QUT-Motorsport/QUTMS_MCISO/hardware/MCISO_board_image.PNG

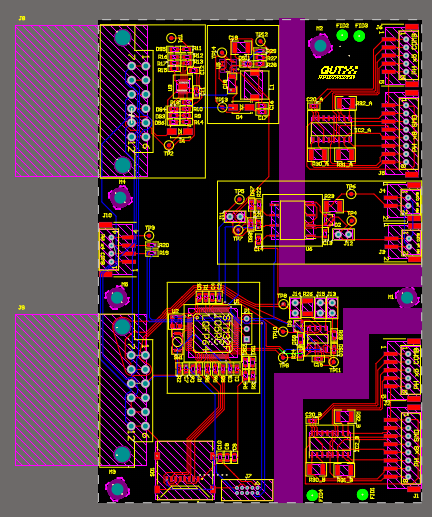
hardware/MCISO_board_image.PNG
