QUT-Motorsport/QUTMS_MCISO/hardware/3D_PCB.PNG

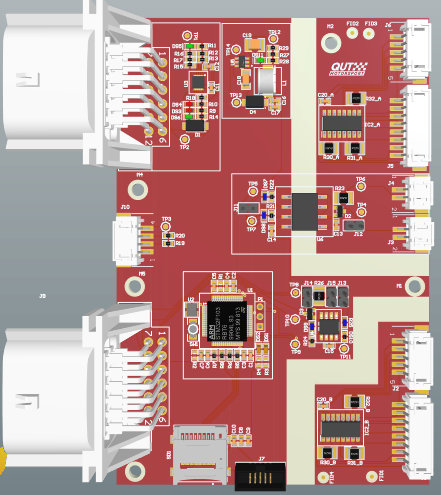
hardware/3D_PCB.PNG
