QUT-Motorsport/QUTMS_MCISO/hardware/JohnAssemblyFiles/QUTMS_MCISO-V01 BOM Expanded.xlsx

Sheet: Pivot
Fit | (Multiple Items)
Row Labels | Count of Designator
1N4448WQ-7-F | 1
47219-2001 | 1
74404064221 | 1
AM26LS32ACDR | 2
B260A-13-F | 1
B3U-1000P | 1
Cap-100nF-0603 | 15
Cap-1uF-0603 | 1
Cap-22uF-1206 | 2
Cap-470nF-0603 | 1
Cap-47uF-1210 | 2
Cap-4u7-0603 | 4
DSC1101CI5-020.0000T | 1
G5V-2-DC12 | 1
Header 3 | 1
IDC 10P 2x5 1.27mm | 1
ISO1050DWR | 1
JST PH 2x RIGHT COMB | 1
JST PH 4x RIGHT COMB | 5
JST PH 5x RIGHT COMB | 2
JST PH 8x Right comb | 2
Jumper 2Way Pins | 2
LED Blue 0603 | 4
LED Green 0603 | 3
LED Orange | 2
LED Red 0603 | 2
LMR14010ADDCR | 1
MAX17612A | 1
NUP2105L | 2
Res-10k-0603 | 2
Res-120R-1210 | 7
Res-150k-0603 | 1
Res-15k-0603 | 1
Res-19k6-0603 | 1
Res-1k-0603 | 2
Res-22R-0603 | 2
Res-240k-0603 | 1
Res-2M2-0603 | 2
Res-330R-0603 | 6
Res-390k-0603 | 1
Res-4k7-0603 | 5
Res-64k9-0603 | 1
SN65HVD232D | 1
STM32F207VGT7 | 1
Grand Total | 98

Sheet: QUTMS_MCISO-V01 BOM Expanded
Comment | Description | Designator | Footprint | LibRef | Quantity | Fit | Unique Part Number | Side
STM32F207VGT7 | ARM Cortex-M3 32-bit MCU, 1024 KB Flash, 128 KB Internal RAM, 82 I/Os, 100-pin LQFP, -40 to 105 degC, Tray | U1 | STM-LQFP100_N | STM32F207VGT7-Custom | 1 | Y | STM32F207VGT7 | T
SN65HVD232D | 3.3 V CAN Transceiver, 17 mA, -40 to 85 degC, 8-pin SOIC (D), Green (RoHS & no Sb/Br) | U4 | D0008A_L | CMP-0315-00073-2 | 1 | Y | SN65HVD232D | T
NUP2105L | NUP2105L | D2 | NUP2105L | NUP2105L | 1 | Y | NUP2105L | T
NUP2105L | NUP2105L | D3 | NUP2105L | NUP2105L | 1 | Y | NUP2105L | T
MAX17612A | 4.5V to 60V, 250mA Current-Limiter with OV, UV, and Reverse Protection | U3 | MAX17612A | MAX17612A | 1 | Y | MAX17612A | T
LMR14010ADDCR | IC REG BUCK ADJ 1A TSOT23-6 | U5 | FP-DDC0006A-MFG | CMP-04918-000056-1 | 1 | Y | LMR14010ADDCR | T
LED Red 0603 | LED Red 0603 | DS3 | LED RED 0603 | LED Red 0603 | 1 | Y | LED Red 0603 | T
LED Red 0603 | LED Red 0603 | DS4 | LED RED 0603 | LED Red 0603 | 1 | Y | LED Red 0603 | T
LED Orange |  | DS1 | LED ORANGE 0603 | LED ORANGE 0603 | 1 | Y | LED Orange | T
LED Orange |  | DS2 | LED ORANGE 0603 | LED ORANGE 0603 | 1 | Y | LED Orange | T
LED Green 0603 | LED Green 0603 | DS5 | LED GREEN 0603 | LED Green 0603 | 1 | Y | LED Green 0603 | T
LED Green 0603 | LED Green 0603 | DS6 | LED GREEN 0603 | LED Green 0603 | 1 | Y | LED Green 0603 | T
LED Green 0603 | LED Green 0603 | DS11 | LED GREEN 0603 | LED Green 0603 | 1 | Y | LED Green 0603 | T
LED Blue 0603 |  | DS7 | LED BLUE 0603 | LED BLUE 0603 | 1 | Y | LED Blue 0603 | T
LED Blue 0603 |  | DS8 | LED BLUE 0603 | LED BLUE 0603 | 1 | Y | LED Blue 0603 | T
LED Blue 0603 |  | DS9 | LED BLUE 0603 | LED BLUE 0603 | 1 | Y | LED Blue 0603 | T
LED Blue 0603 |  | DS10 | LED BLUE 0603 | LED BLUE 0603 | 1 | Y | LED Blue 0603 | T
Jumper 2Way Solderable | Jumper 2Way Side Solderable | J11 | Jumper_2Way_Solderable | Jumper 2Way Side Solderable | 1 | N | Jumper 2Way Solderable | T
Jumper 2Way Solderable | Jumper 2Way Side Solderable | J13 | Jumper_2Way_Solderable | Jumper 2Way Side Solderable | 1 | N | Jumper 2Way Solderable | T
Jumper 2Way Solderable | Jumper 2Way Side Solderable | J14 | Jumper_2Way_Solderable | Jumper 2Way Side Solderable | 1 | N | Jumper 2Way Solderable | T
Jumper 2Way Solderable | Jumper 2Way Side Solderable | J16 | Jumper_2Way_Solderable | Jumper 2Way Side Solderable | 1 | N | Jumper 2Way Solderable | T
Jumper 2Way Pins | Jumper 2Way Side Pins | J8 | Jumper_2Way_Pin | Jumper 2Way Side Pins | 1 | THRU | Jumper 2Way Pins | T
Jumper 2Way Pins | Jumper 2Way Side Pins | J9 | Jumper_2Way_Pin | Jumper 2Way Side Pins | 1 | THRU | Jumper 2Way Pins | T
JST PH 8x Right comb |  | J1 | JST PH 8x RIGHT SMD | JST PH 8x Right comb | 1 | Y | JST PH 8x Right comb | T
JST PH 8x Right comb |  | J5 | JST PH 8x RIGHT SMD | JST PH 8x Right comb | 1 | Y | JST PH 8x Right comb | T
JST PH 5x RIGHT COMB |  | J2 | JST PH 5x RIGHT COMB | JST PH 5x RIGHT COMB | 1 | Y | JST PH 5x RIGHT COMB | T
JST PH 5x RIGHT COMB |  | J6 | JST PH 5x RIGHT COMB | JST PH 5x RIGHT COMB | 1 | Y | JST PH 5x RIGHT COMB | T
JST PH 4x RIGHT COMB |  | J3 | JST PH 4x RIGHT COMB | JST PH 4x RIGHT COMB | 1 | Y | JST PH 4x RIGHT COMB | T
JST PH 4x RIGHT COMB |  | J4 | JST PH 4x RIGHT COMB | JST PH 4x RIGHT COMB_1 | 1 | Y | JST PH 4x RIGHT COMB | T
JST PH 4x RIGHT COMB |  | J10 | JST PH 4x RIGHT COMB | JST PH 4x RIGHT COMB | 1 | Y | JST PH 4x RIGHT COMB | T
JST PH 4x RIGHT COMB |  | J15 | JST PH 4x RIGHT COMB | JST PH 4x RIGHT COMB | 1 | Y | JST PH 4x RIGHT COMB | T
JST PH 4x RIGHT COMB | CAN Ethernet Bridge Port | J12 | JST PH 4x RIGHT COMB | JST PH 4x RIGHT COMB | 1 | Y | JST PH 4x RIGHT COMB | T
JST PH 2x RIGHT COMB |  | J17 | JST PH 2x RIGHT COMB | JST PH 2x RIGHT COMB | 1 | Y | JST PH 2x RIGHT COMB | T
ISO1050DWR | Isolated CAN Transceiver, -55 to 105 degC, 16-pin SOIC (DW), Green (RoHS & no Sb/Br) | U7 | DW00016B_V | ISO1050DWR | 1 | Y | ISO1050DWR | T
IDC 10P 2x5 1.27mm | IDC 10P 2x5 1.27mm | J7 | IDC 1.27MM 10P | IDC 10P 2x5 1.27mm | 1 | THRU | IDC 10P 2x5 1.27mm | T
Hole M3 Tight Unplated | M3.2 Hole, No Plating | M1 | M3.2 UNPLATED | Hole M3 Tight Unplated | 1 | N | Hole M3 Tight Unplated | T
Hole M3 Tight Unplated | M3.2 Hole, No Plating | M2 | M3.2 UNPLATED | Hole M3 Tight Unplated | 1 | N | Hole M3 Tight Unplated | T
Hole M3 Tight Unplated | M3.2 Hole, No Plating | M3 | M3.2 UNPLATED | Hole M3 Tight Unplated | 1 | N | Hole M3 Tight Unplated | T
Hole M3 Tight Unplated | M3.2 Hole, No Plating | M4 | M3.2 UNPLATED | Hole M3 Tight Unplated | 1 | N | Hole M3 Tight Unplated | T
Header 3 | Header, 3-Pin | P1 | HDR1X3 | Header 3 | 1 | THRU | Header 3 | T
G5V-2-DC12 | General Purpose Relay DPDT (2 Form C) Through Hole, 12V, 2A | K1 | G5V-2 | G5V-2-DC12 | 1 | THRU | G5V-2-DC12 | T
DSC1101CI5-020.0000T | No Description Available | U2 | VDFN6_3P2X2P5_MCH | DSC1101CI5-020.0000T | 1 | Y | DSC1101CI5-020.0000T | T
B260A-13-F | Diode, Schottky Barrier Rectifier, 60 V, 2 A, B260A-13-F | D4 | SMA | B260A-13-F | 1 | Y | B260A-13-F | T
B3U-1000P | Omron B3U-1000P Ultra Miniture Switch | SW1 | BTN B3U-1000P | BTN B3U-1000P | 1 | Y | B3U-1000P | T
AM26LS32ACDR | Integrated Circuit | IC2_A | 16PinHallFootprint | AM26LS32ACDR | 1 | Y | AM26LS32ACDR | T
AM26LS32ACDR | Integrated Circuit | IC2_B | 16PinHallFootprint | AM26LS32ACDR | 1 | Y | AM26LS32ACDR | T
74404064221 | FIXED IND 220UH 660MA 850 MOHM | L1 | Inductor_6x6mm | 74404064221 | 1 | Y | 74404064221 | T
47219-2001 | MicroSD Card Connector, Hinge Type, -40 to 85 degC, 8-Pin SMD, RoHS, Tape and Reel | SD1 | MOLX-47219-2001-8_V | CMP-2000-05245-1 | 1 | Y | 47219-2001 | T
470nF 50V 5% | Capacitor, Ceramic, SMD, 470nF, 50V, 5%, X7R, 0603 | C12 | Cap_Ceramic_0603 | 470nF 50V 5% X7R 0603 | 1 | Y | Cap-470nF-0603 | T
390k 5% | Resistor, SMD, 390k, 0.1W, 5%, 0603 | R16 | Res_ThinFilm_0603 | 390k 5% 0603 | 1 | Y | Res-390k-0603 | T
330R | Resistor, SMD, 330R, 0.1W, 5%, 0603 | R3 | Res_ThinFilm_0603 | 330R 5% 0603 | 1 | Y | Res-330R-0603 | T
330R | Resistor, SMD, 330R, 0.1W, 5%, 0603 | R4 | Res_ThinFilm_0603 | 330R 5% 0603 | 1 | Y | Res-330R-0603 | T
330R | Resistor, SMD, 330R, 0.1W, 5%, 0603 | R21 | Res_ThinFilm_0603 | 330R 5% 0603 | 1 | Y | Res-330R-0603 | T
330R | Resistor, SMD, 330R, 0.1W, 5%, 0603 | R22 | Res_ThinFilm_0603 | 330R 5% 0603 | 1 | Y | Res-330R-0603 | T
330R | Resistor, SMD, 330R, 0.1W, 5%, 0603 | R24 | Res_ThinFilm_0603 | 330R 5% 0603 | 1 | Y | Res-330R-0603 | T
330R | Resistor, SMD, 330R, 0.1W, 5%, 0603 | R25 | Res_ThinFilm_0603 | 330R 5% 0603 | 1 | Y | Res-330R-0603 | T
240k 5% | Resistor, SMD, 240k, 0.1W, 5%, 0603 | R17 | Res_ThinFilm_0603 | 240k 5% 0603 | 1 | Y | Res-240k-0603 | T
150k 5% 0603 | Resistor, SMD, 150k, 0.1W, 5%, 0603 | R15 | Res_ThinFilm_0603 | 150k 5%, 0603 | 1 | Y | Res-150k-0603 | T
120R 1% 1210 | Resistor, SMD, 120R, 0.25W, 1%, 1210 | R19_A | Res_ThinFilm_1210 | 120R 1% 1210 | 1 | Y | Res-120R-1210 | B
120R 1% 1210 | Resistor, SMD, 120R, 0.25W, 1%, 1210 | R19_B | Res_ThinFilm_1210 | 120R 1% 1210 | 1 | Y | Res-120R-1210 | B
120R 1% 1210 | Resistor, SMD, 120R, 0.25W, 1%, 1210 | R20_A | Res_ThinFilm_1210 | 120R 1% 1210 | 1 | Y | Res-120R-1210 | B
120R 1% 1210 | Resistor, SMD, 120R, 0.25W, 1%, 1210 | R20_B | Res_ThinFilm_1210 | 120R 1% 1210 | 1 | Y | Res-120R-1210 | B
120R 1% 1210 | Resistor, SMD, 120R, 0.25W, 1%, 1210 | R23_A | Res_ThinFilm_1210 | 120R 1% 1210 | 1 | Y | Res-120R-1210 | B
120R 1% 1210 | Resistor, SMD, 120R, 0.25W, 1%, 1210 | R23_B | Res_ThinFilm_1210 | 120R 1% 1210 | 1 | Y | Res-120R-1210 | B
120R 1% 1210 | Resistor, SMD, 120R, 0.25W, 1%, 1210 | R26 | Res_ThinFilm_1210 | 120R 1% 1210 | 1 | Y | Res-120R-1210 | T
100nF 100V | Capacitor, Ceramic, SMD, 100nF, 100V, 5%, X7R, 0603 | C6 | Cap_Ceramic_0603 | 100nF 100V 5% X7R 0603 | 1 | Y | Cap-100nF-0603 | T
100nF 100V | Capacitor, Ceramic, SMD, 100nF, 100V, 5%, X7R, 0603 | C7 | Cap_Ceramic_0603 | 100nF 100V 5% X7R 0603 | 1 | Y | Cap-100nF-0603 | T
100nF 100V | Capacitor, Ceramic, SMD, 100nF, 100V, 5%, X7R, 0603 | C15 | Cap_Ceramic_0603 | 100nF 100V 5% X7R 0603 | 1 | Y | Cap-100nF-0603 | T
100nF 50V 5% X7R 0603 | Capacitor, Ceramic, SMD, 100nF, 50V, 5%, X7R, 0603 | C13 | Cap_Ceramic_0603 | 100nF 50V 5% X7R 0603 | 1 | Y | Cap-100nF-0603 | T
100nF 50V 5% X7R 0603 | Capacitor, Ceramic, SMD, 100nF, 50V, 5%, X7R, 0603 | C23 | Cap_Ceramic_0603 | 100nF 50V 5% X7R 0603 | 1 | Y | Cap-100nF-0603 | T
100nF 50V | Capacitor, Ceramic, SMD, 100nF, 50V, 5%, X7R, 0603 | C16 | Cap_Ceramic_0603 | 100nF 50V 5% X7R 0603 | 1 | Y | Cap-100nF-0603 | T
100nF 50V | Capacitor, Ceramic, SMD, 100nF, 50V, 5%, X7R, 0603 | C17 | Cap_Ceramic_0603 | 100nF 50V 5% X7R 0603 | 1 | Y | Cap-100nF-0603 | T
100nF | Capacitor, Ceramic, SMD, 100nF, 50V, 5%, X7R, 0603 | C1 | Cap_Ceramic_0603 | 100nF 50V 5% X7R 0603 | 1 | Y | Cap-100nF-0603 | T
100nF | Capacitor, Ceramic, SMD, 100nF, 50V, 5%, X7R, 0603 | C2 | Cap_Ceramic_0603 | 100nF 50V 5% X7R 0603 | 1 | Y | Cap-100nF-0603 | T
100nF | Capacitor, Ceramic, SMD, 100nF, 50V, 5%, X7R, 0603 | C3 | Cap_Ceramic_0603 | 100nF 50V 5% X7R 0603 | 1 | Y | Cap-100nF-0603 | T
100nF | Capacitor, Ceramic, SMD, 100nF, 50V, 5%, X7R, 0603 | C4 | Cap_Ceramic_0603 | 100nF 50V 5% X7R 0603 | 1 | Y | Cap-100nF-0603 | T
100nF | Capacitor, Ceramic, SMD, 100nF, 50V, 5%, X7R, 0603 | C10 | Cap_Ceramic_0603 | 100nF 50V 5% X7R 0603 | 1 | Y | Cap-100nF-0603 | T
100nF | Capacitor, Ceramic, SMD, 100nF, 50V, 5%, X7R, 0603 | C24 | Cap_Ceramic_0603 | 100nF 50V 5% X7R 0603 | 1 | Y | Cap-100nF-0603 | T
64k9 1% | Resistor, SMD, 64k9, 0.1W, 5%, 0603 | R27 | Res_ThinFilm_0603 | 64k9 1% 0603 | 1 | Y | Res-64k9-0603 | T
47uF 16V 1210 | Capacitor, Ceramic, SMD, 47uF, 16V, 5%, X7R, 1210 | C19 | Cap_Ceramic_1210 | 47uF 16V 10% X7R 1210 | 1 | Y | Cap-47uF-1210 | T
47uF 16V 1210 | Capacitor, Ceramic, SMD, 47uF, 16V, 5%, X7R, 1210 | C22 | Cap_Ceramic_1210 | 47uF 16V 10% X7R 1210 | 1 | Y | Cap-47uF-1210 | T
22uF 35V | 22µF ±20% 35V Ceramic Capacitor X5R 1206 (3216 Metric) | C18 | Cap_Ceramic_1206 | 22uF 35V 20% X5R 1206 | 1 | Y | Cap-22uF-1206 | T
22uF 35V | 22µF ±20% 35V Ceramic Capacitor X5R 1206 (3216 Metric) | C21 | Cap_Ceramic_1206 | 22uF 35V 20% X5R 1206 | 1 | Y | Cap-22uF-1206 | T
22R | Resistor, SMD, 22R, 0.1W, 1%, 0603 | R5 | Res_ThinFilm_0603 | 22R 1% 0603 | 1 | Y | Res-22R-0603 | T
22R | Resistor, SMD, 22R, 0.1W, 1%, 0603 | R6 | Res_ThinFilm_0603 | 22R 1% 0603 | 1 | Y | Res-22R-0603 | T
19k6 1% | Resistor, SMD, 19k6, 0.1W, 5%, 0603 | R29 | Res_ThinFilm_0603 | 19k6 1% 0603 | 1 | Y | Res-19k6-0603 | T
15k 5% 0603 | Resistor, SMD, 15k, 0.1W, 5%, 0603 | R8 | Res_ThinFilm_0603 | 15k 5% 0603 | 1 | Y | Res-15k-0603 | T
10k 5% 0603 | Resistor, SMD, 10k, 0.1W, 5%, 0603 | R7 | Res_ThinFilm_0603 | 10k 5% 0603 | 1 | Y | Res-10k-0603 | T
10k 5% 0603 | Resistor, SMD, 10k, 0.1W, 5%, 0603 | R30 | Res_ThinFilm_0603 | 10k 5% 0603 | 1 | N | Res-10k-0603 | T
10k 5% 0603 | Resistor, SMD, 10k, 0.1W, 5%, 0603 | R31 | Res_ThinFilm_0603 | 10k 5% 0603 | 1 | N | Res-10k-0603 | T
10k 5% 0603 | Resistor, SMD, 10k, 0.1W, 5%, 0603 | R32 | Res_ThinFilm_0603 | 10k 5% 0603 | 1 | N | Res-10k-0603 | T
10k 5% 0603 | Resistor, SMD, 10k, 0.1W, 5%, 0603 | R33 | Res_ThinFilm_0603 | 10k 5% 0603 | 1 | N | Res-10k-0603 | T
10k 5% 0603 | Resistor, SMD, 10k, 0.1W, 5%, 0603 | R34 | Res_ThinFilm_0603 | 10k 5% 0603 | 1 | N | Res-10k-0603 | T
10k 1% 0603 | Resistor, SMD, 20k, 0.1W, 5%, 0603 | R1 | Res_ThinFilm_0603 | 20k 1% 0603 | 1 | Y | Res-10k-0603 | T
4u7 50V 5% | Capacitor, Ceramic, SMD, 4u7, 50V, 5%, X7R, 0603 | C11 | Cap_Ceramic_0603 | 4u7 50V 5% X7R 0603 | 1 | Y | Cap-4u7-0603 | T
4u7 | Capacitor, Ceramic, SMD, 4u7, 50V, 5%, X7R, 0603 | C5 | Cap_Ceramic_0603 | 4u7 50V 5% X7R 0603 | 1 | Y | Cap-4u7-0603 | T
4u7 | Capacitor, Ceramic, SMD, 4u7, 50V, 5%, X7R, 0603 | C8 | Cap_Ceramic_0603 | 4u7 50V 5% X7R 0603 | 1 | Y | Cap-4u7-0603 | T
4u7 | Capacitor, Ceramic, SMD, 4u7, 50V, 5%, X7R, 0603 | C14 | Cap_Ceramic_0603 | 4u7 50V 5% X7R 0603 | 1 | Y | Cap-4u7-0603 | T
4k7 5% 0603 | Resistor, SMD, 4k7, 0.1W, 5%, 0603 | R9 | Res_ThinFilm_0603 | 4k7 5% 0603 | 1 | Y | Res-4k7-0603 | T
4k7 5% 0603 | Resistor, SMD, 4k7, 0.1W, 5%, 0603 | R10 | Res_ThinFilm_0603 | 4k7 5% 0603 | 1 | Y | Res-4k7-0603 | T
4k7 5% 0603 | Resistor, SMD, 4k7, 0.1W, 5%, 0603 | R11 | Res_ThinFilm_0603 | 4k7 5% 0603 | 1 | Y | Res-4k7-0603 | T
4k7 5% 0603 | Resistor, SMD, 4k7, 0.1W, 5%, 0603 | R14 | Res_ThinFilm_0603 | 4k7 5% 0603 | 1 | Y | Res-4k7-0603 | T
4k7 | Resistor, SMD, 4k7, 0.1W, 5%, 0603 | R2 | Res_ThinFilm_0603 | 4k7 5% 0603 | 1 | Y | Res-4k7-0603 | T
2M2 1% | Resistor, SMD, 2M2, 0.125W, 1%, 0603 | R12 | Res_ThinFilm_0603 | 2M2 1% 0603 | 1 | Y | Res-2M2-0603 | T
2M2 1% | Resistor, SMD, 2M2, 0.125W, 1%, 0603 | R13 | Res_ThinFilm_0603 | 2M2 1% 0603 | 1 | Y | Res-2M2-0603 | T
1uF | Capacitor, Ceramic, SMD, 1uF, 25V, 5%, X7R, 0603 | C9 | Cap_Ceramic_0603 | 1uF 25V 5% X7R 0603 | 1 | Y | Cap-1uF-0603 | T
1N4448WQ-7-F | Diode, SMD, 75V, 5%, 250mA, SOD123 | D1 | SMA | 1N4448WQ-7-F | 1 | Y | 1N4448WQ-7-F | T
1k 5% 0603 | Resistor, SMD, 1k, 0.1W, 5%, 0603 | R18 | Res_ThinFilm_0603 | 1k 5% 0603 | 1 | Y | Res-1k-0603 | T
1k | Resistor, SMD, 1k, 0.1W, 5%, 0603 | R28 | Res_ThinFilm_0603 | 1k 5% 0603 | 1 | Y | Res-1k-0603 | T
0.1u | Capacitor, Ceramic, SMD, 4u7, 50V, 5%, X7R, 0603 | C20_A | Cap_Ceramic_0603 | 4u7 50V 5% X7R 0603 | 1 | Y | Cap-100nF-0603 | B
0.1u | Capacitor, Ceramic, SMD, 4u7, 50V, 5%, X7R, 0603 | C20_B | Cap_Ceramic_0603 | 4u7 50V 5% X7R 0603 | 1 | Y | Cap-100nF-0603 | B

Sheet: Create Part Numbers
470nF 50V 5% | C | 470n | 470nF 50V 5% | Cap_Ceramic_0603 | Cap | 470nF | 0603 | Cap-470nF-0603
390k 5% | R | 390k | 390k 5% | Res_ThinFilm_0603 | Res | 390k | 0603 | Res-390k-0603
330R | R | 330R | 330R | Res_ThinFilm_0603 | Res | 330R | 0603 | Res-330R-0603
240k 5% | R | 240k | 240k 5% | Res_ThinFilm_0603 | Res | 240k | 0603 | Res-240k-0603
150k 5% 0603 | R | 150k | 150k 5% 0603 | Res_ThinFilm_0603 | Res | 150k | 0603 | Res-150k-0603
120R 1% 1210 | R | 120R | 120R 1% 1210 | Res_ThinFilm_1210 | Res | 120R | 1210 | Res-120R-1210
100nF 100V | C | 100n | 100nF 100V | Cap_Ceramic_0603 | Cap | 100nF | 0603 | Cap-100nF-0603
100nF 50V 5% X7R 0603 | C | 100n | 100nF 50V 5% X7R 0603 | Cap_Ceramic_0603 | Cap | 100nF | 0603 | Cap-100nF-0603
100nF 50V | C | 100n | 100nF 50V | Cap_Ceramic_0603 | Cap | 100nF | 0603 | Cap-100nF-0603
100nF | C | 100n | 100nF | Cap_Ceramic_0603 | Cap | 100nF | 0603 | Cap-100nF-0603
64k9 1% | R | 64k9 | 64k9 1% | Res_ThinFilm_0603 | Res | 64k9 | 0603 | Res-64k9-0603
47uF 16V 1210 | C | 47u | 47uF 16V 1210 | Cap_Ceramic_1210 | Cap | 47uF | 1210 | Cap-47uF-1210
22uF 35V | C | 22u | 22uF 35V | Cap_Ceramic_1206 | Cap | 22uF | 1206 | Cap-22uF-1206
22R | R | 22R | 22R | Res_ThinFilm_0603 | Res | 22R | 0603 | Res-22R-0603
19k6 1% | R | 19k6 | 19k6 1% | Res_ThinFilm_0603 | Res | 19k6 | 0603 | Res-19k6-0603
15k 5% 0603 | R | 15k | 15k 5% 0603 | Res_ThinFilm_0603 | Res | 15k | 0603 | Res-15k-0603
10k 5% 0603 | R | 10k | 10k 5% 0603 | Res_ThinFilm_0603 | Res | 10k | 0603 | Res-10k-0603
10k 1% 0603 | R | 10k | 10k 1% 0603 | Res_ThinFilm_0603 | Res | 10k | 0603 | Res-10k-0603
4u7 50V 5% | C | 4u7 | 4u7 50V 5% | Cap_Ceramic_0603 | Cap | 4u7 | 0603 | Cap-4u7-0603
4u7 | C | 4u7 | 4u7 | Cap_Ceramic_0603 | Cap | 4u7 | 0603 | Cap-4u7-0603
4k7 5% 0603 | R | 4k7 | 4k7 5% 0603 | Res_ThinFilm_0603 | Res | 4k7 | 0603 | Res-4k7-0603
4k7 | R | 4k7 | 4k7 | Res_ThinFilm_0603 | Res | 4k7 | 0603 | Res-4k7-0603
2M2 1% | R | 2M2 | 2M2 1% | Res_ThinFilm_0603 | Res | 2M2 | 0603 | Res-2M2-0603
1uF | C | 1u | 1uF | Cap_Ceramic_0603 | Cap | 1uF | 0603 | Cap-1uF-0603
1k 5% 0603 | R | 1k | 1k 5% 0603 | Res_ThinFilm_0603 | Res | 1k | 0603 | Res-1k-0603
1k | R | 1k | 1k | Res_ThinFilm_0603 | Res | 1k | 0603 | Res-1k-0603
0.1u | C | 100n | 100nF | Cap_Ceramic_0603 | Cap | 100nF | 0603 | Cap-100nF-0603
