QUT-Motorsport/QUTMS_MCISO/hardware/Project Outputs for QUTMS_MCISO-V01/QUTMS_MCISO-V01 Assemble.xlsx

Comment | Description | Designator | Footprint | LibRef | Quantity
TestPoint_SMD |  | TP4, TP6, TP8, TP9, TP10, TP11 | TestPointSMD | TestPoint_SMD | 6
TestPoint |  | TP2, TP3 | TestPointSMD | TestPoint | 2
STM32F207VGT7 | ARM Cortex-M3 32-bit MCU, 1024 KB Flash, 128 KB Internal RAM, 82 I/Os, 100-pin LQFP, -40 to 105 degC, Tray | U1 | STM-LQFP100_N | STM32F207VGT7-Custom | 1
SN65HVD232D | 3.3 V CAN Transceiver, 17 mA, -40 to 85 degC, 8-pin SOIC (D), Green (RoHS & no Sb/Br) | U4 | D0008A_L | CMP-0315-00073-2 | 1
NUP2105L | NUP2105L | D2, D3 | NUP2105L | NUP2105L | 2
MAX17612A | 4.5V to 60V, 250mA Current-Limiter with OV, UV, and Reverse Protection | U3 | MAX17612A | MAX17612A | 1
LMR14010ADDCR | IC REG BUCK ADJ 1A TSOT23-6 | U5 | FP-DDC0006A-MFG | CMP-04918-000056-1 | 1
LED Red 0603 | LED Red 0603 | DS3, DS4 | LED RED 0603 | LED Red 0603 | 2
LED Orange |  | DS1, DS2 | LED ORANGE 0603 | LED ORANGE 0603 | 2
LED Green 0603 | LED Green 0603 | DS5, DS6, DS11 | LED GREEN 0603 | LED Green 0603 | 3
LED Blue 0603 |  | DS7, DS8, DS9, DS10 | LED BLUE 0603 | LED BLUE 0603 | 4
Jumper 2Way Solderable | Jumper 2Way Side Solderable | J11, J13, J14, J16 | Jumper_2Way_Solderable | Jumper 2Way Side Solderable | 4
Jumper 2Way Pins | Jumper 2Way Side Pins | J8, J9 | Jumper_2Way_Pin | Jumper 2Way Side Pins | 2
JST PH 8x Right comb |  | J1, J5 | JST PH 8x RIGHT SMD | JST PH 8x Right comb | 2
JST PH 5x RIGHT COMB |  | J2, J6 | JST PH 5x RIGHT COMB | JST PH 5x RIGHT COMB | 2
JST PH 4x RIGHT COMB | [NoValue], CAN Ethernet Bridge Port | J3, J4, J10, J12, J15 | JST PH 4x RIGHT COMB | JST PH 4x RIGHT COMB, JST PH 4x RIGHT COMB_1 | 5
JST PH 2x RIGHT COMB |  | J17 | JST PH 2x RIGHT COMB | JST PH 2x RIGHT COMB | 1
ISO1050DWR | Isolated CAN Transceiver, -55 to 105 degC, 16-pin SOIC (DW), Green (RoHS & no Sb/Br) | U7 | DW00016B_V | ISO1050DWR | 1
IDC 10P 2x5 1.27mm | IDC 10P 2x5 1.27mm | J7 | IDC 1.27MM 10P | IDC 10P 2x5 1.27mm | 1
Hole M3 Tight Unplated | M3.2 Hole, No Plating | M1, M2, M3, M4 | M3.2 UNPLATED | Hole M3 Tight Unplated | 4
Header 3 | Header, 3-Pin | P1 | HDR1X3 | Header 3 | 1
G5V-2-DC12 | General Purpose Relay DPDT (2 Form C) Through Hole, 12V, 2A | K1 | G5V-2 | G5V-2-DC12 | 1
DSC1101CI5-020.0000T | No Description Available | U2 | VDFN6_3P2X2P5_MCH | DSC1101CI5-020.0000T | 1
B260A-13-F | Diode, Schottky Barrier Rectifier, 60 V, 2 A, B260A-13-F | D4 | SMA | B260A-13-F | 1
B3U-1000P | Omron B3U-1000P Ultra Miniture Switch | SW1 | BTN B3U-1000P | BTN B3U-1000P | 1
AM26LS32ACDR | Integrated Circuit | IC2_A, IC2_B | 16PinHallFootprint | AM26LS32ACDR | 2
74404064221 | FIXED IND 220UH 660MA 850 MOHM | L1 | Inductor_6x6mm | 74404064221 | 1
47219-2001 | MicroSD Card Connector, Hinge Type, -40 to 85 degC, 8-Pin SMD, RoHS, Tape and Reel | SD1 | MOLX-47219-2001-8_V | CMP-2000-05245-1 | 1
470nF 50V 5% | Capacitor, Ceramic, SMD, 470nF, 50V, 5%, X7R, 0603 | C12 | Cap_Ceramic_0603 | 470nF 50V 5% X7R 0603 | 1
390k 5% | Resistor, SMD, 390k, 0.1W, 5%, 0603 | R16 | Res_ThinFilm_0603 | 390k 5% 0603 | 1
330R | Resistor, SMD, 330R, 0.1W, 5%, 0603 | R3, R4, R21, R22, R24, R25 | Res_ThinFilm_0603 | 330R 5% 0603 | 6
240k 5% | Resistor, SMD, 240k, 0.1W, 5%, 0603 | R17 | Res_ThinFilm_0603 | 240k 5% 0603 | 1
150k 5% 0603 | Resistor, SMD, 150k, 0.1W, 5%, 0603 | R15 | Res_ThinFilm_0603 | 150k 5%, 0603 | 1
120R 1% 1210 | Resistor, SMD, 120R, 0.25W, 1%, 1210 | R19_A, R19_B, R20_A, R20_B, R23_A, R23_B, R26 | Res_ThinFilm_1210 | 120R 1% 1210 | 7
100nF 100V | Capacitor, Ceramic, SMD, 100nF, 100V, 5%, X7R, 0603 | C6, C7, C15 | Cap_Ceramic_0603 | 100nF 100V 5% X7R 0603 | 3
100nF 50V 5% X7R 0603 | Capacitor, Ceramic, SMD, 100nF, 50V, 5%, X7R, 0603 | C13, C23 | Cap_Ceramic_0603 | 100nF 50V 5% X7R 0603 | 2
100nF 50V | Capacitor, Ceramic, SMD, 100nF, 50V, 5%, X7R, 0603 | C16, C17 | Cap_Ceramic_0603 | 100nF 50V 5% X7R 0603 | 2
100nF | Capacitor, Ceramic, SMD, 100nF, 50V, 5%, X7R, 0603 | C1, C2, C3, C4, C10, C24 | Cap_Ceramic_0603 | 100nF 50V 5% X7R 0603 | 6
64k9 1% | Resistor, SMD, 64k9, 0.1W, 5%, 0603 | R27 | Res_ThinFilm_0603 | 64k9 1% 0603 | 1
47uF 16V 1210 | Capacitor, Ceramic, SMD, 47uF, 16V, 5%, X7R, 1210 | C19, C22 | Cap_Ceramic_1210 | 47uF 16V 10% X7R 1210 | 2
22uF 35V | 22µF ±20% 35V Ceramic Capacitor X5R 1206 (3216 Metric) | C18, C21 | Cap_Ceramic_1206 | 22uF 35V 20% X5R 1206 | 2
22R | Resistor, SMD, 22R, 0.1W, 1%, 0603 | R5, R6 | Res_ThinFilm_0603 | 22R 1% 0603 | 2
19k6 1% | Resistor, SMD, 19k6, 0.1W, 5%, 0603 | R29 | Res_ThinFilm_0603 | 19k6 1% 0603 | 1
15k 5% 0603 | Resistor, SMD, 15k, 0.1W, 5%, 0603 | R8 | Res_ThinFilm_0603 | 15k 5% 0603 | 1
10k 5% 0603 | Resistor, SMD, 10k, 0.1W, 5%, 0603 | R7, R30, R31, R32, R33, R34 | Res_ThinFilm_0603 | 10k 5% 0603 | 6
10k 1% 0603 | Resistor, SMD, 20k, 0.1W, 5%, 0603 | R1 | Res_ThinFilm_0603 | 20k 1% 0603 | 1
4u7 50V 5% | Capacitor, Ceramic, SMD, 4u7, 50V, 5%, X7R, 0603 | C11 | Cap_Ceramic_0603 | 4u7 50V 5% X7R 0603 | 1
4u7 | Capacitor, Ceramic, SMD, 4u7, 50V, 5%, X7R, 0603 | C5, C8, C14 | Cap_Ceramic_0603 | 4u7 50V 5% X7R 0603 | 3
4k7 5% 0603 | Resistor, SMD, 4k7, 0.1W, 5%, 0603 | R9, R10, R11, R14 | Res_ThinFilm_0603 | 4k7 5% 0603 | 4
4k7 | Resistor, SMD, 4k7, 0.1W, 5%, 0603 | R2 | Res_ThinFilm_0603 | 4k7 5% 0603 | 1
2M2 1% | Resistor, SMD, 2M2, 0.125W, 1%, 0603 | R12, R13 | Res_ThinFilm_0603 | 2M2 1% 0603 | 2
1uF | Capacitor, Ceramic, SMD, 1uF, 25V, 5%, X7R, 0603 | C9 | Cap_Ceramic_0603 | 1uF 25V 5% X7R 0603 | 1
1N4448WQ-7-F | Diode, SMD, 75V, 5%, 250mA, SOD123 | D1 | SMA | 1N4448WQ-7-F | 1
1k 5% 0603 | Resistor, SMD, 1k, 0.1W, 5%, 0603 | R18 | Res_ThinFilm_0603 | 1k 5% 0603 | 1
1k | Resistor, SMD, 1k, 0.1W, 5%, 0603 | R28 | Res_ThinFilm_0603 | 1k 5% 0603 | 1
0.1u | Capacitor, Ceramic, SMD, 4u7, 50V, 5%, X7R, 0603 | C20_A, C20_B | Cap_Ceramic_0603 | 4u7 50V 5% X7R 0603 | 2
