QUT-Motorsport/QUTMS_MCISO/hardware/JohnAssemblyFiles/AssemblyDrawing.pdf

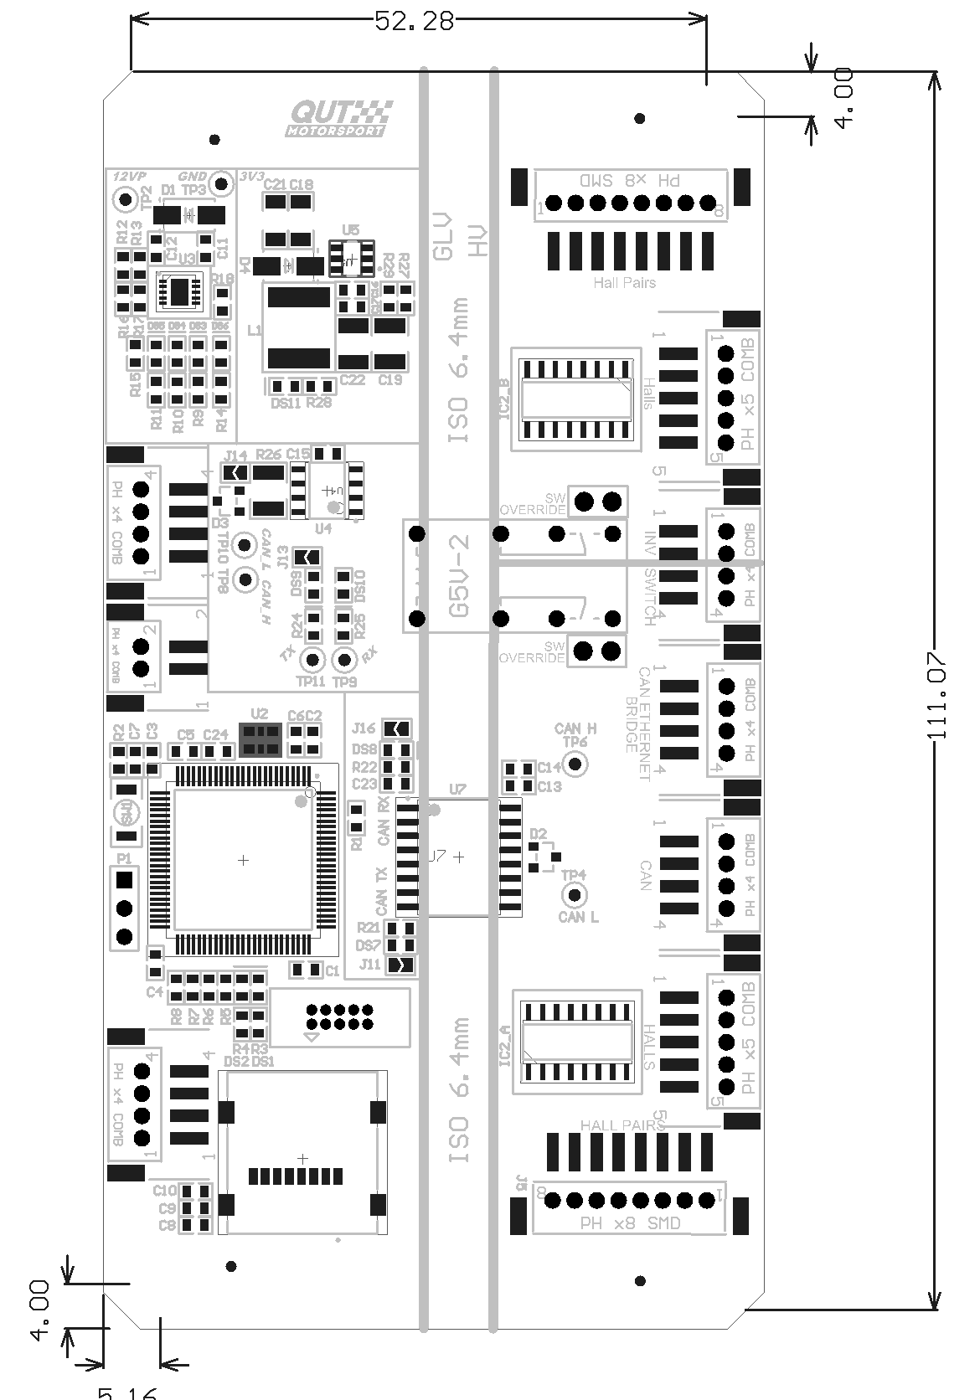
[picture p3: page 1]

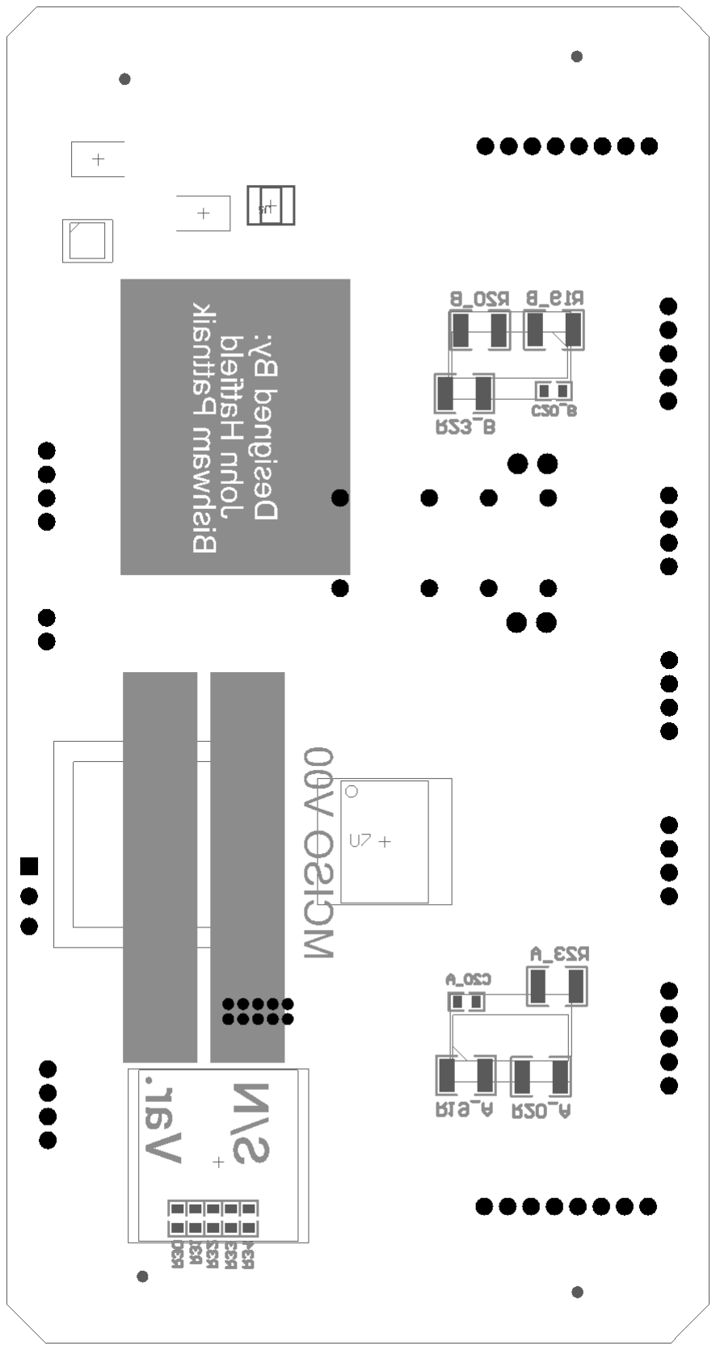
[picture p4: figure]
