QUT-Motorsport/QUTMS_MCISO/hardware/QUTMS_MCISO-V01.pdf

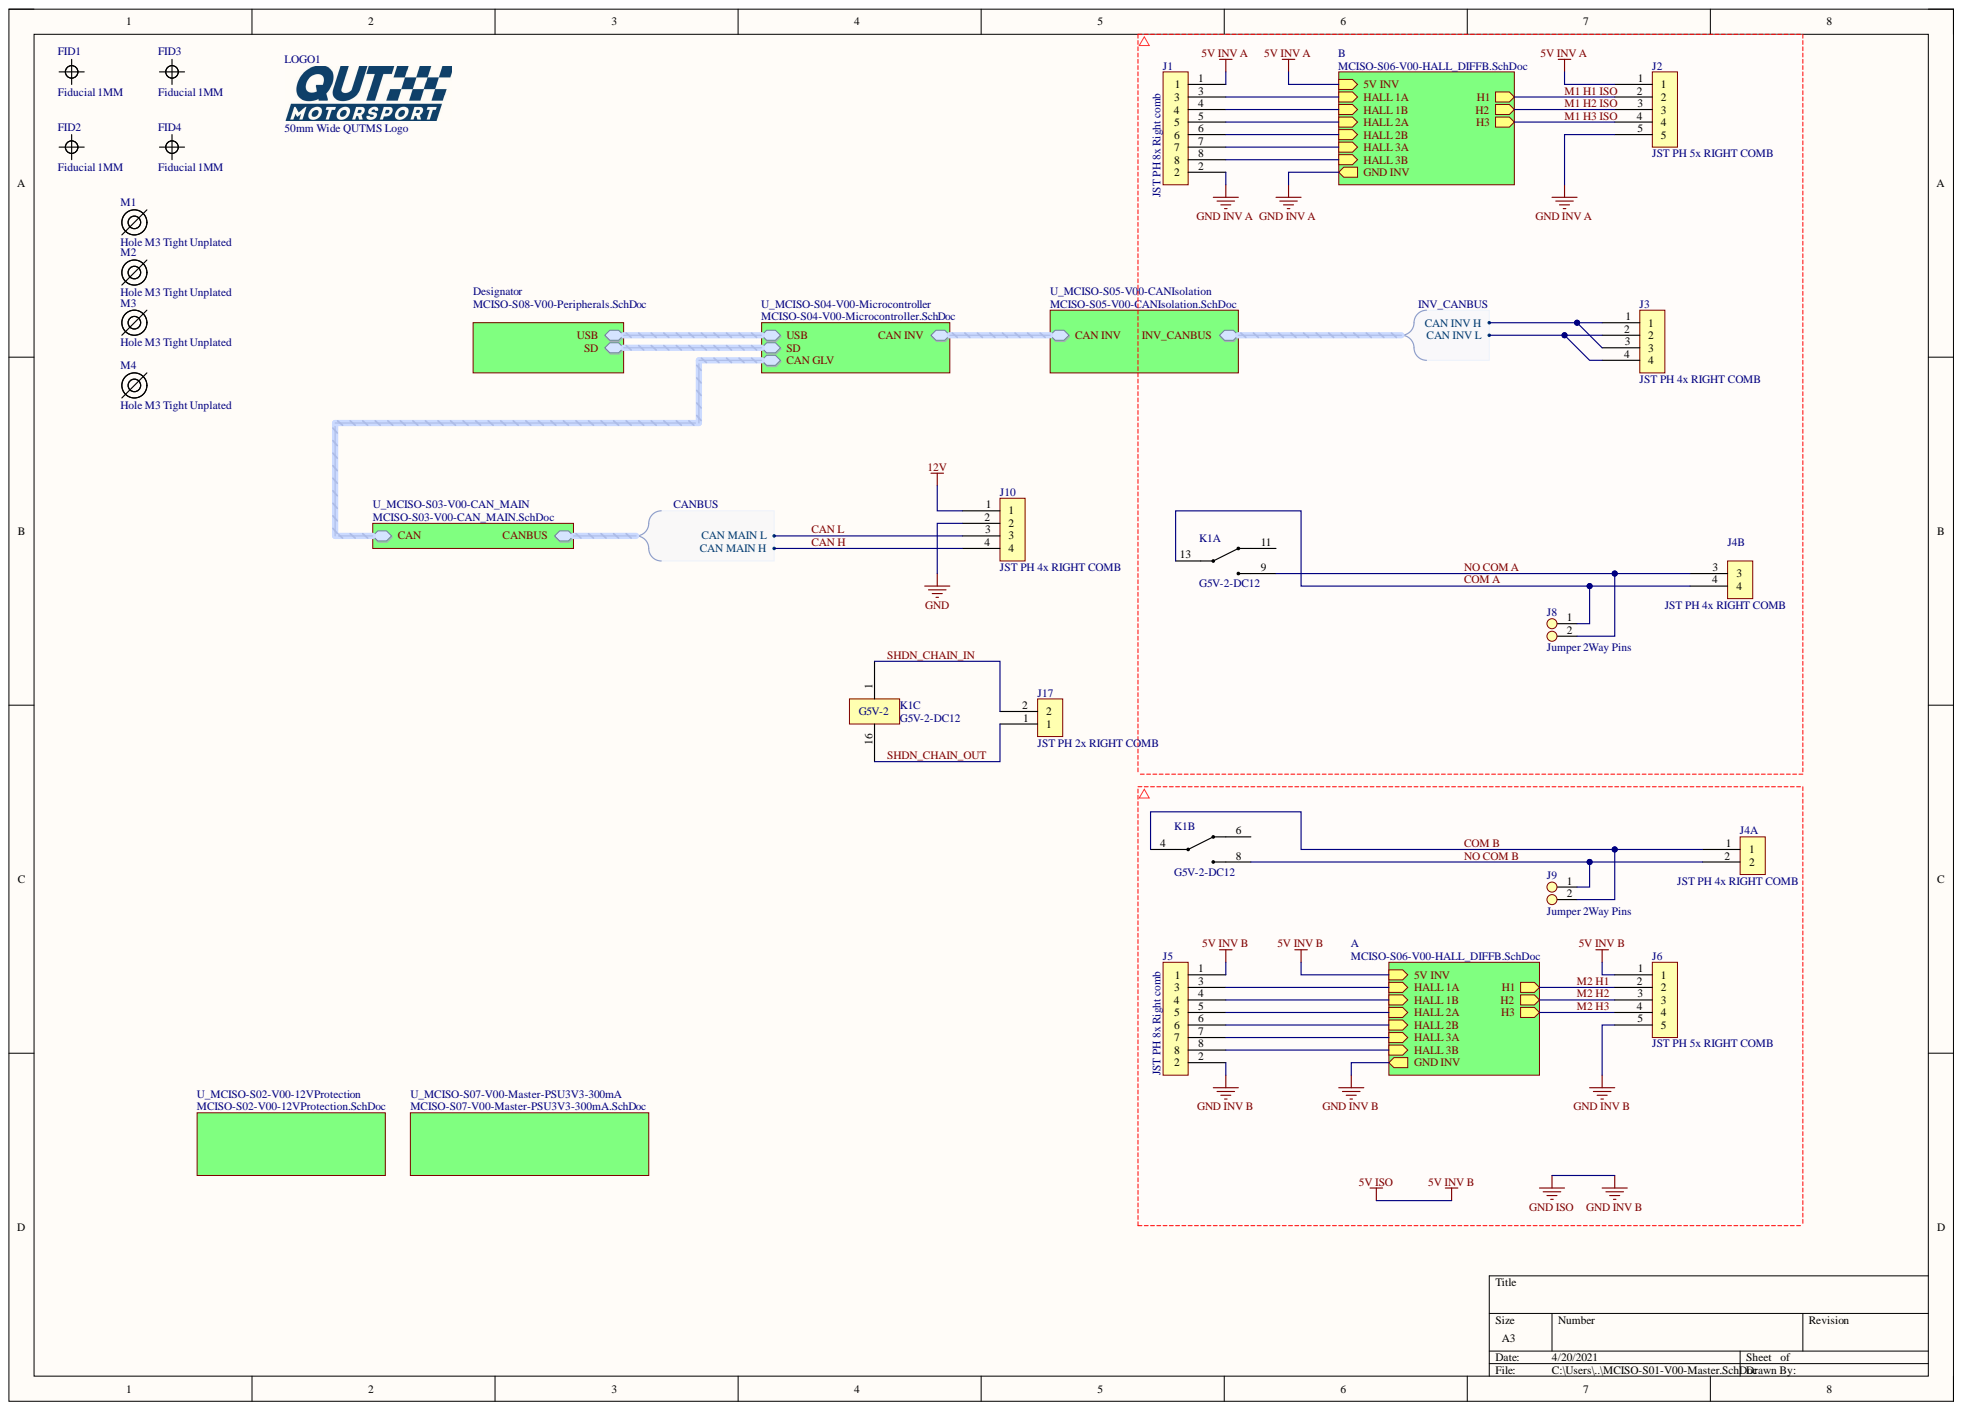
[picture p5: page 1]

JST PH 8x Right comb

JST PH 5x RIGHT COMB

JST PH 4x RIGHT COMB

JST PH 2x RIGHT COMB

GND ISO GND INV B

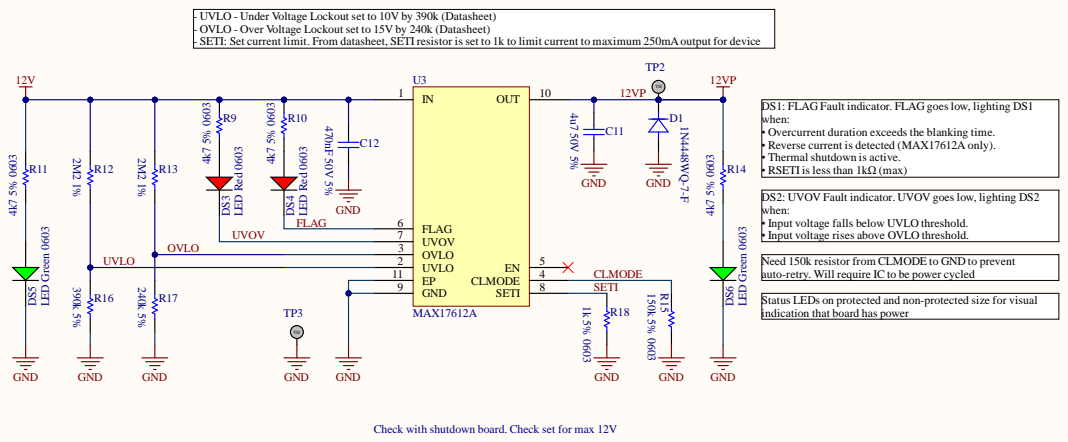
[picture p6: page 2]

to be power cycled

1 1 | 4
9 | 8 | SE T I

that board has power

s on protected and non-protected

ion.SchD Drawn Boy: c

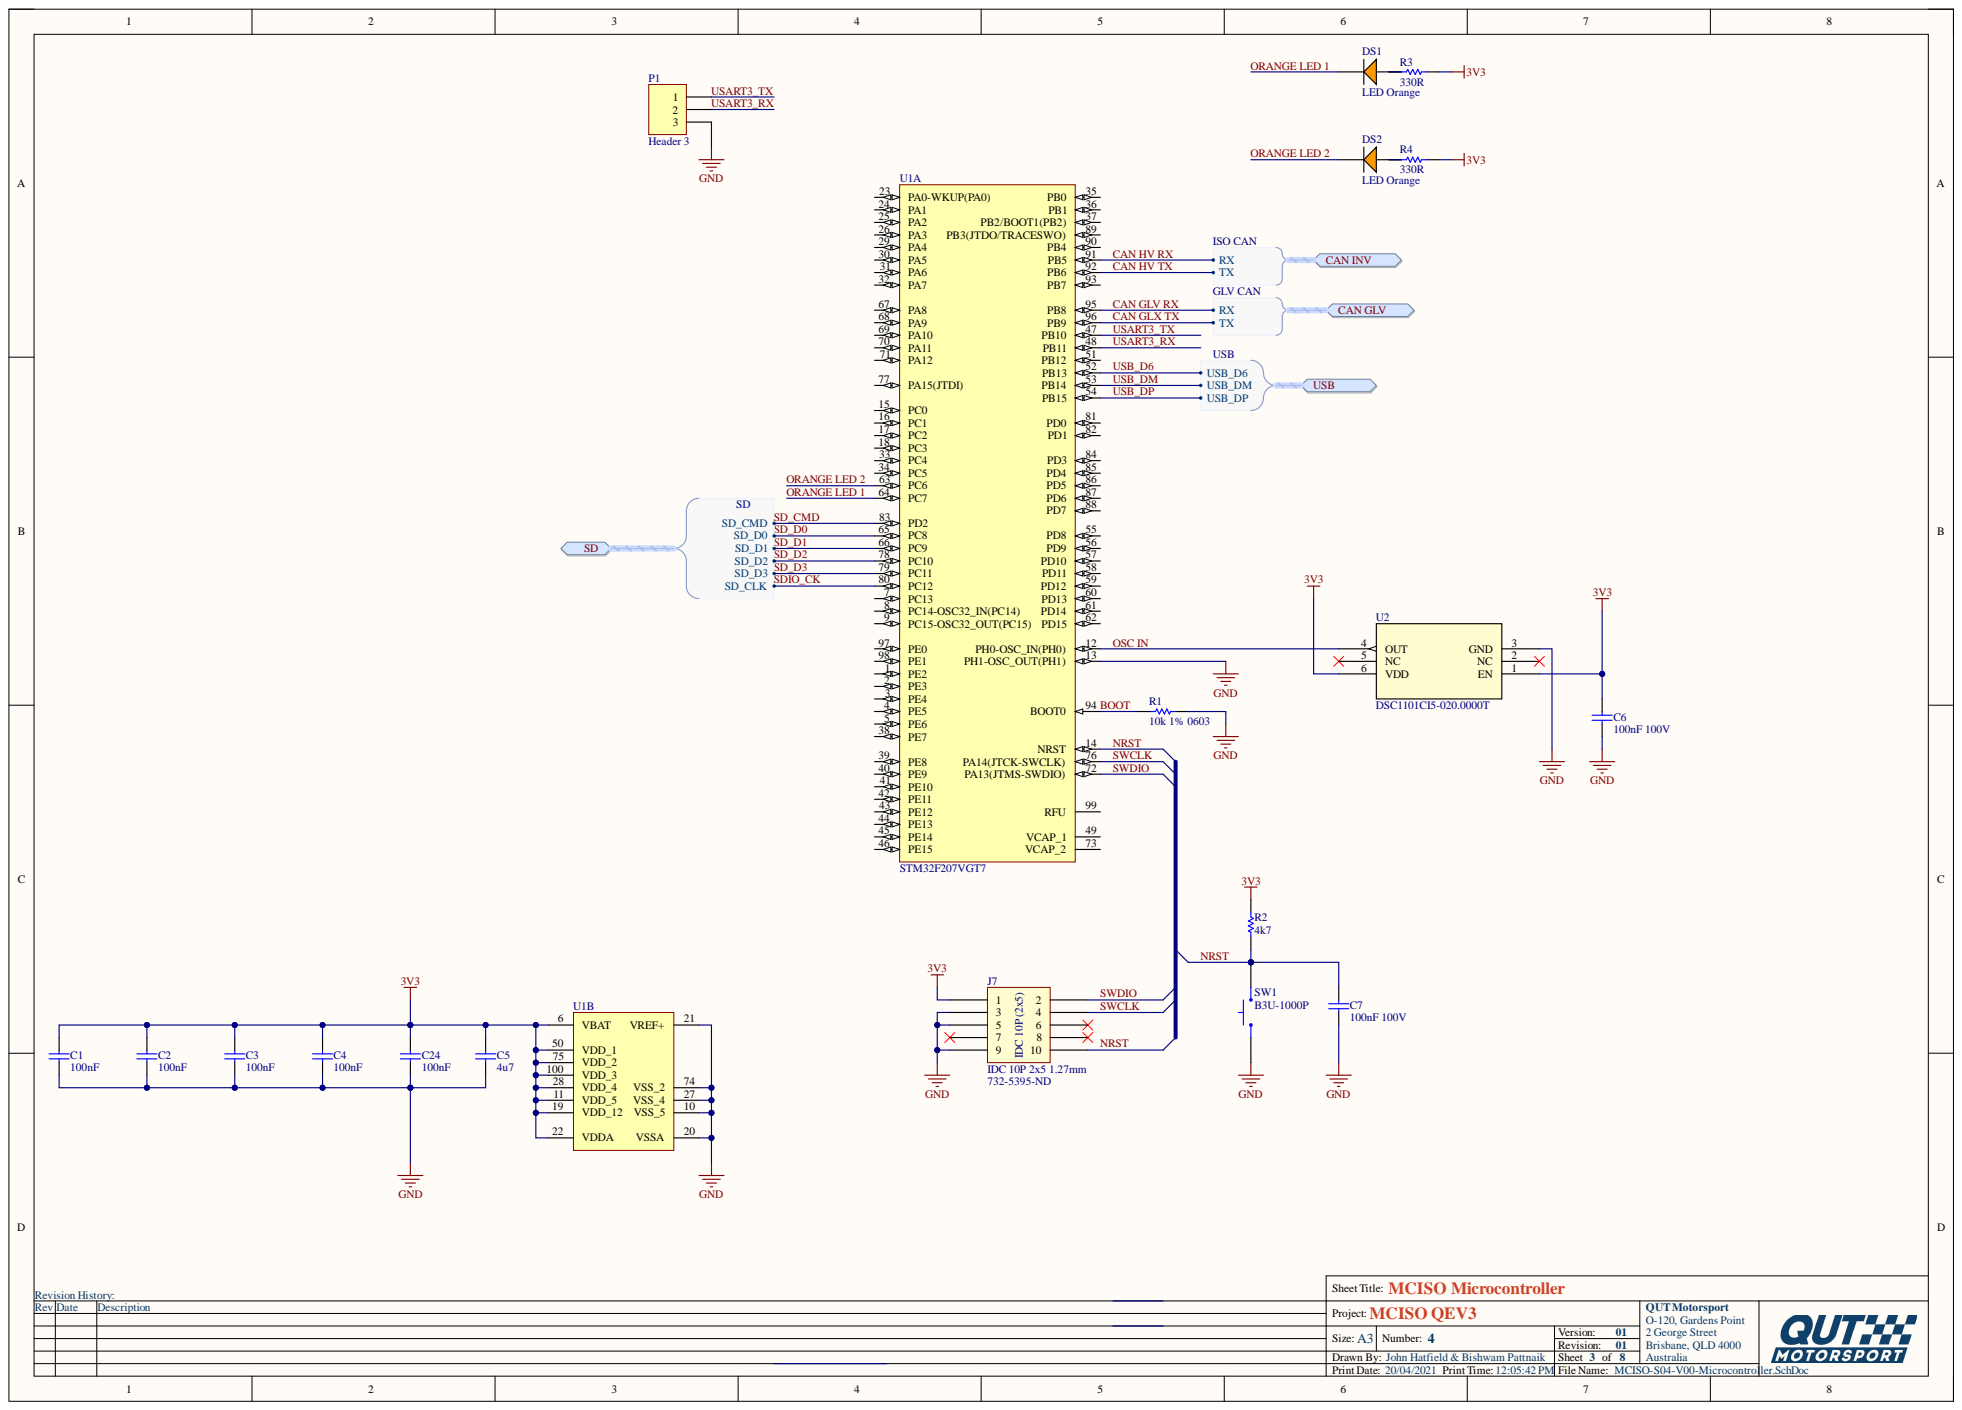
[picture p7: page 3]

Sheet Title: MCISO Microcontroller
MCISO QEV3

Drawn By: John Hatfield & Bishwam Pattnaik

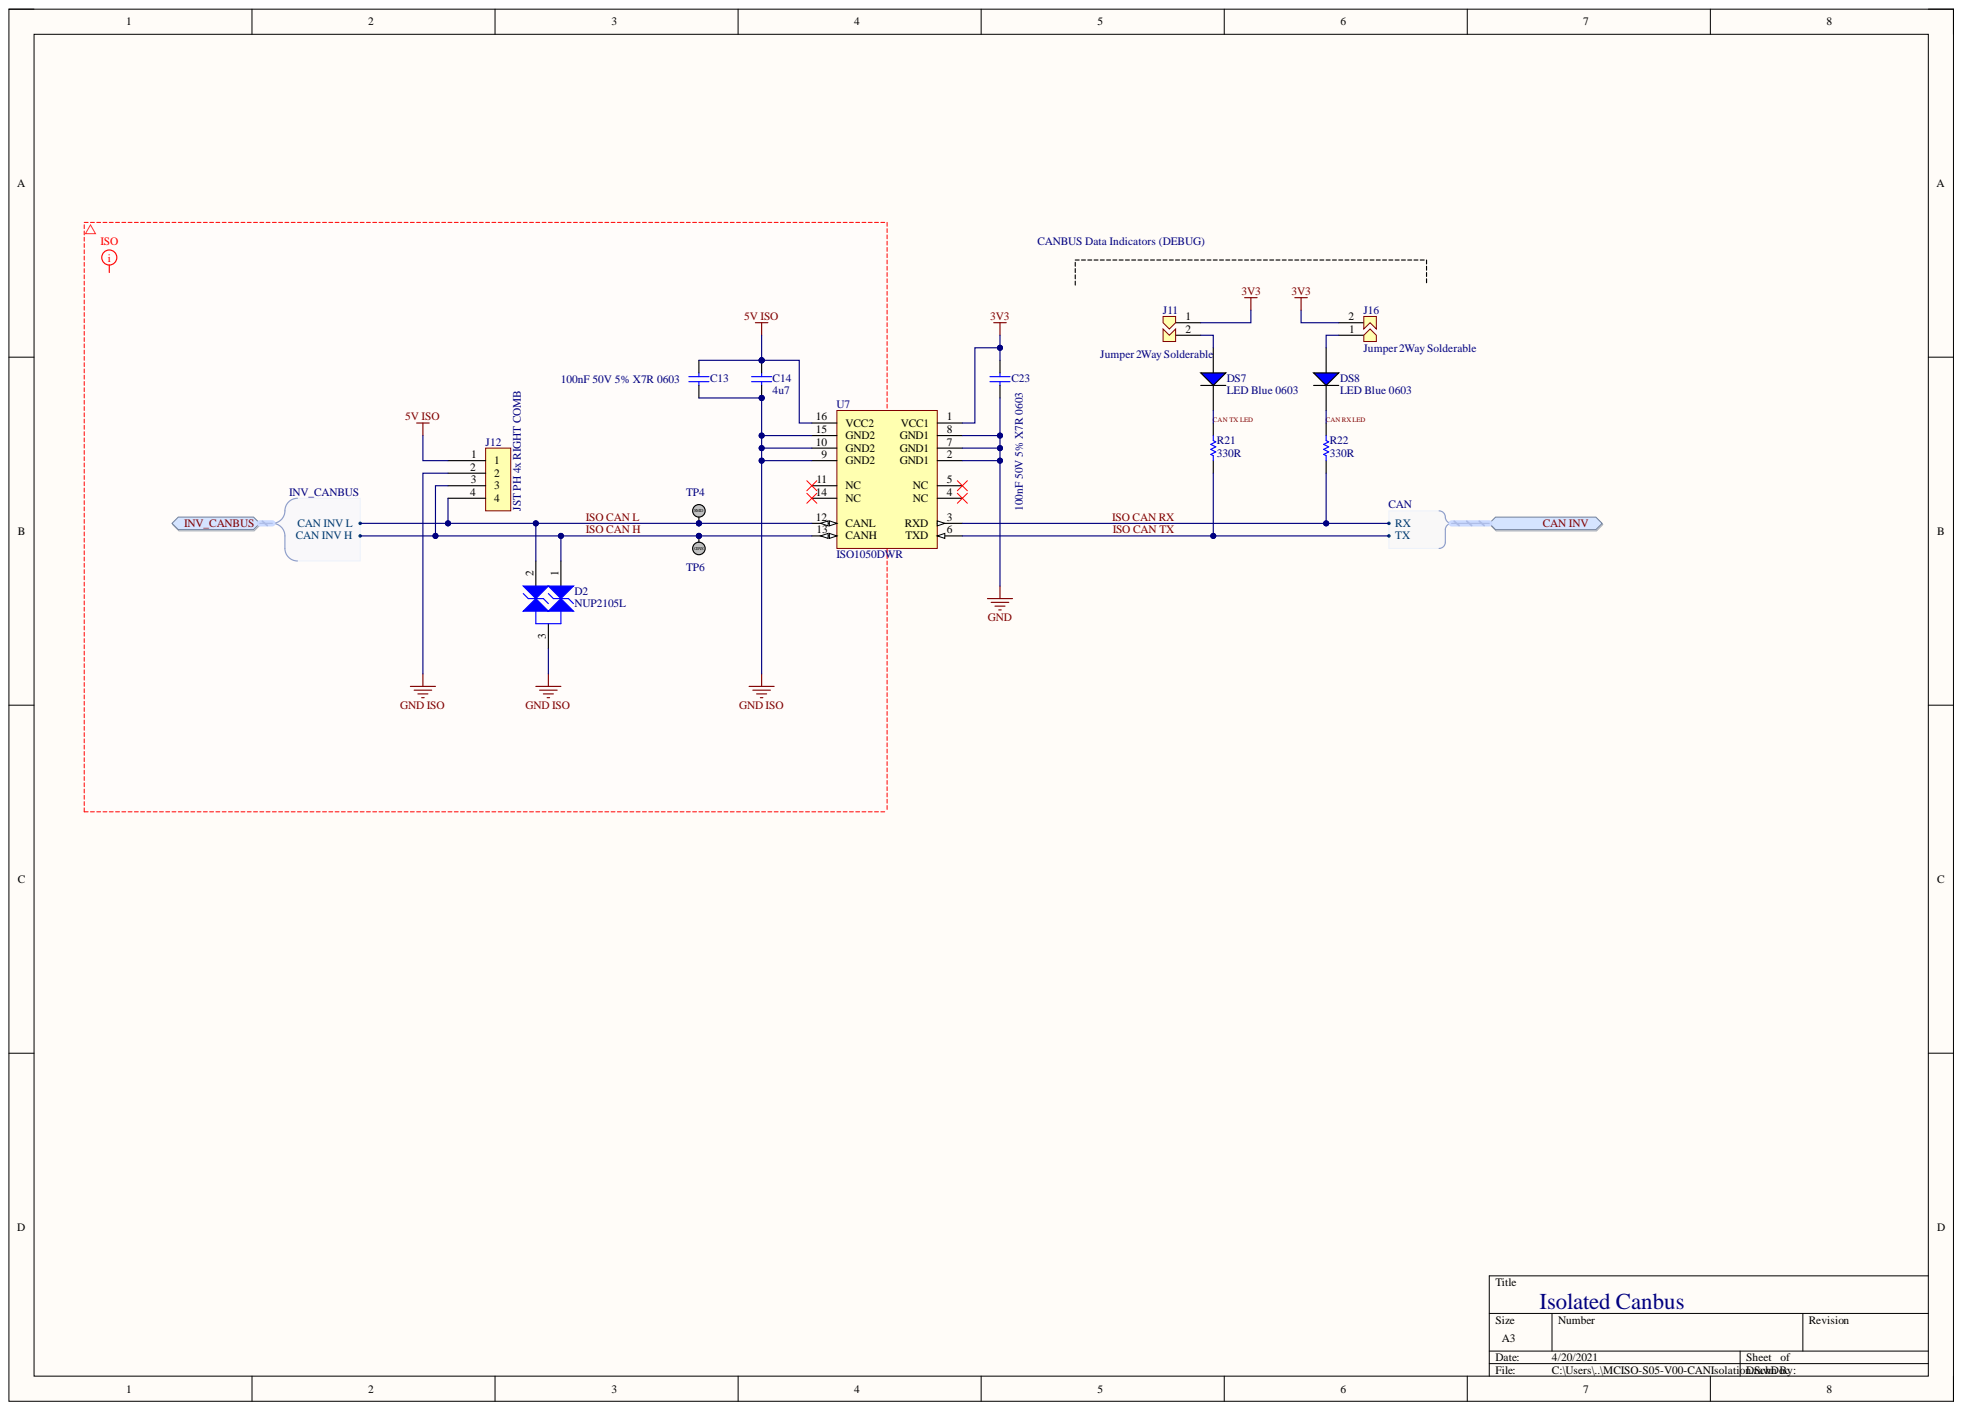
[picture p8: page 4]

JST PH 4x RIGHT COMB

ion.SchD Drawn Bocy:

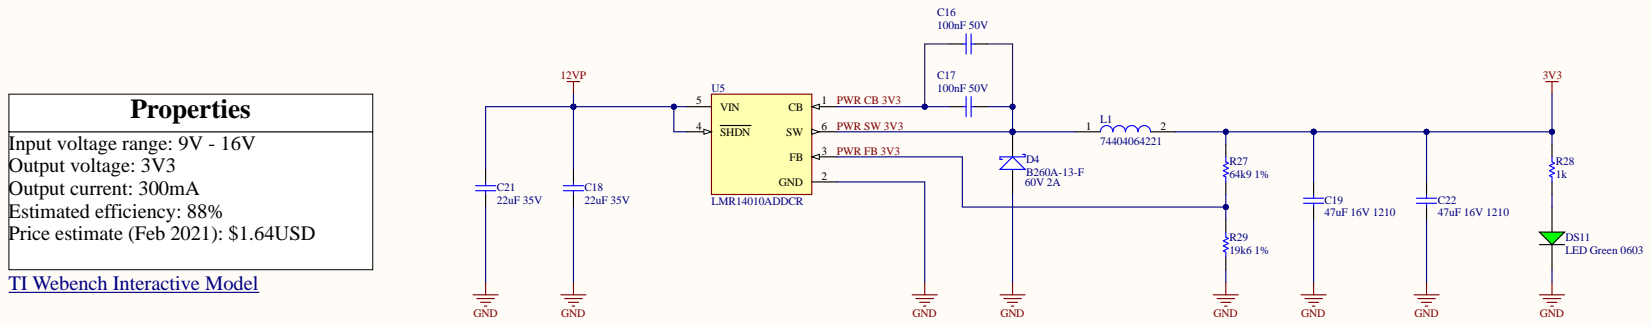
[picture p9: page 5]

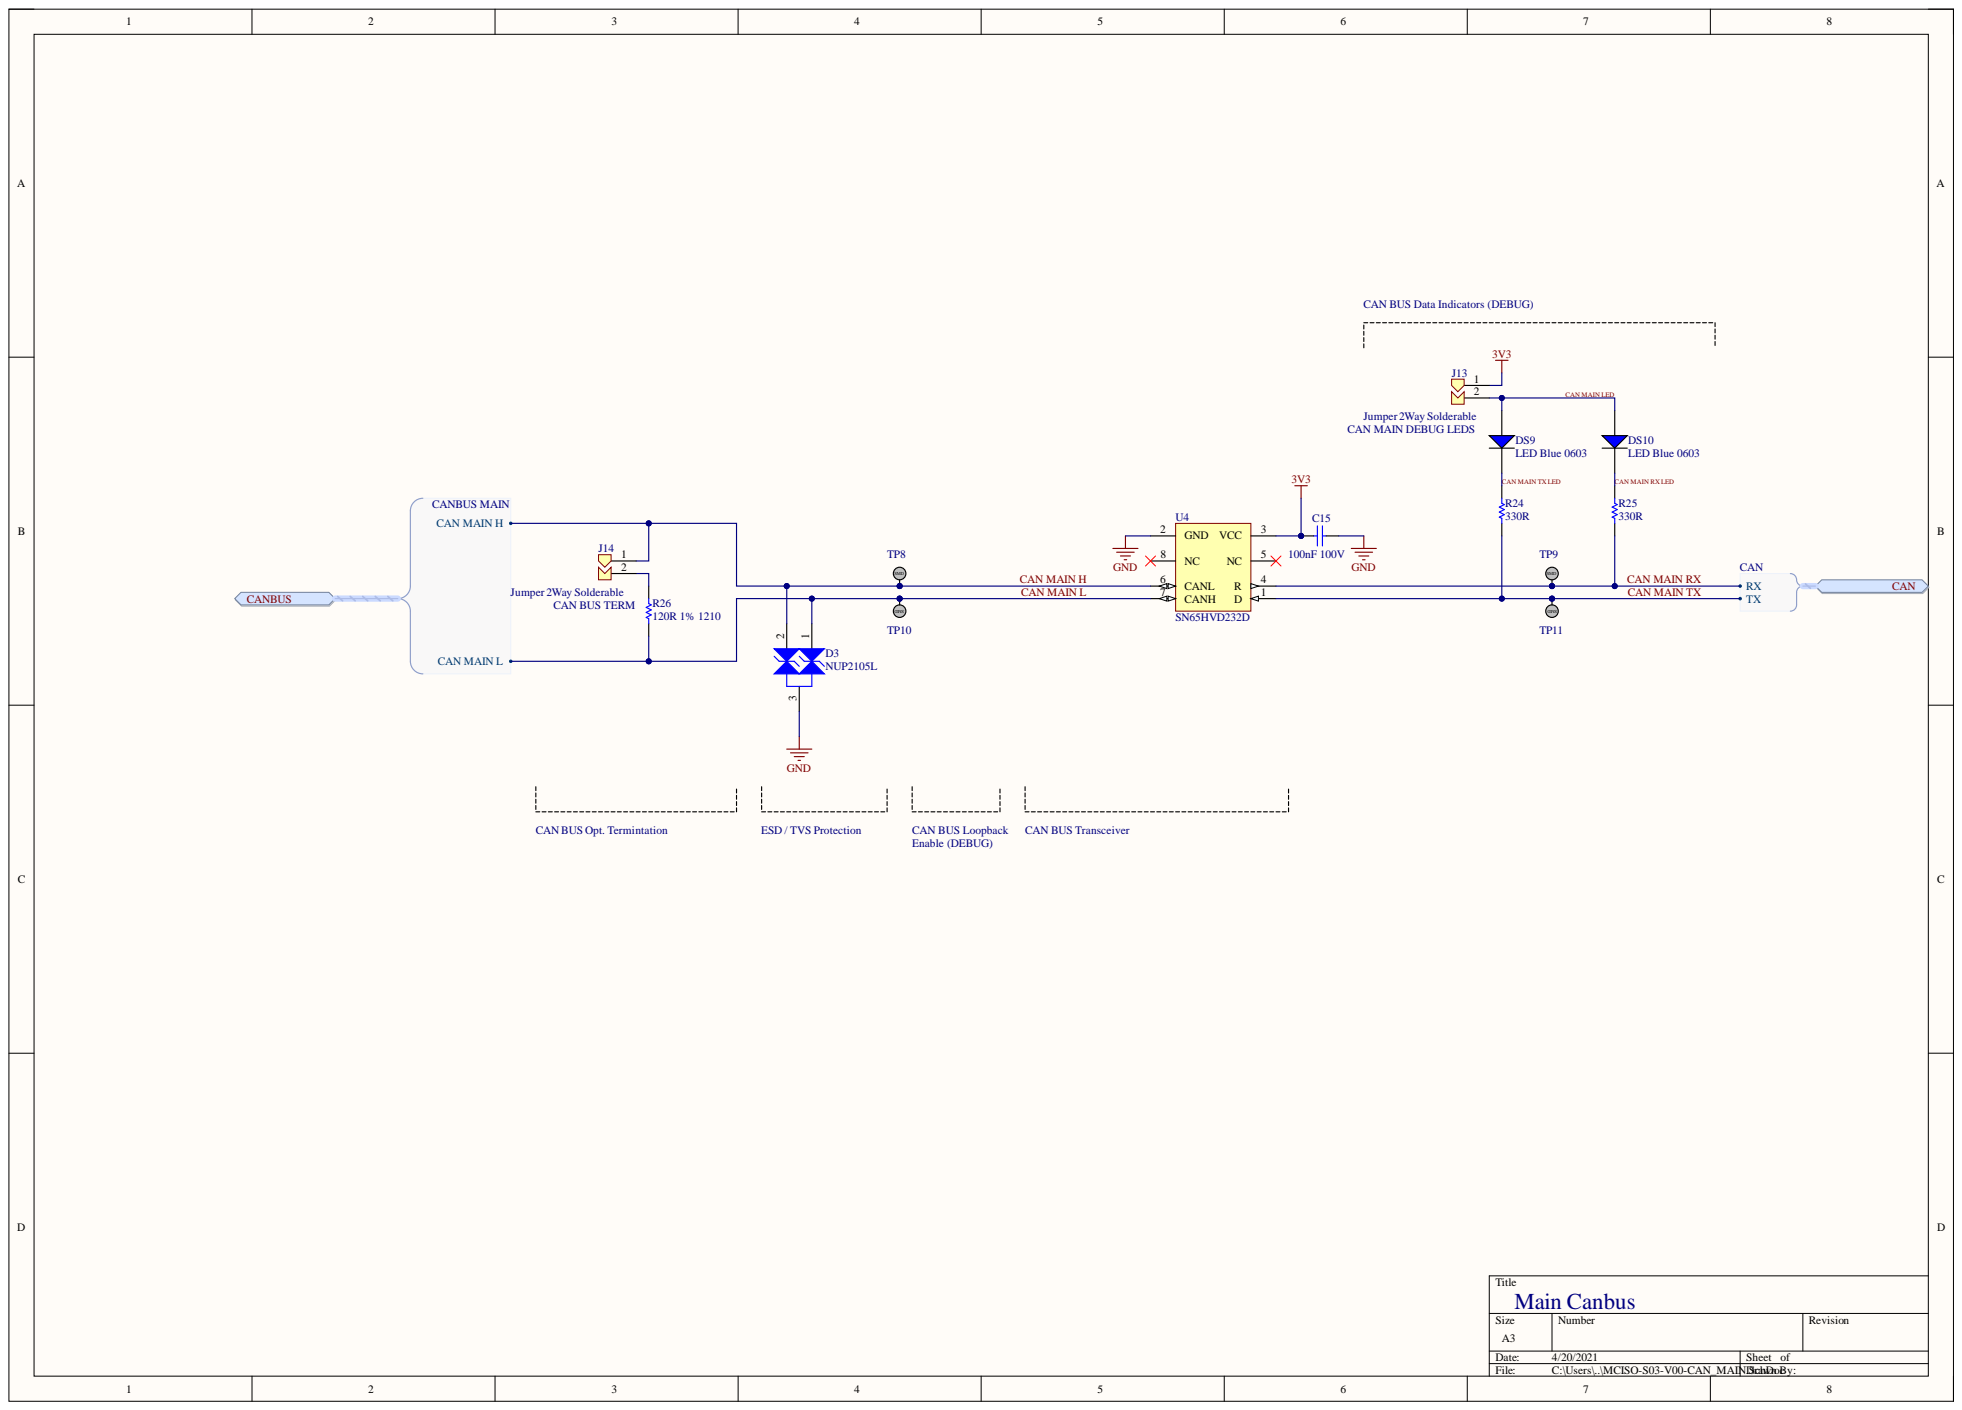
[picture p10: page 6]

IN.SchD Drawn Boc y:

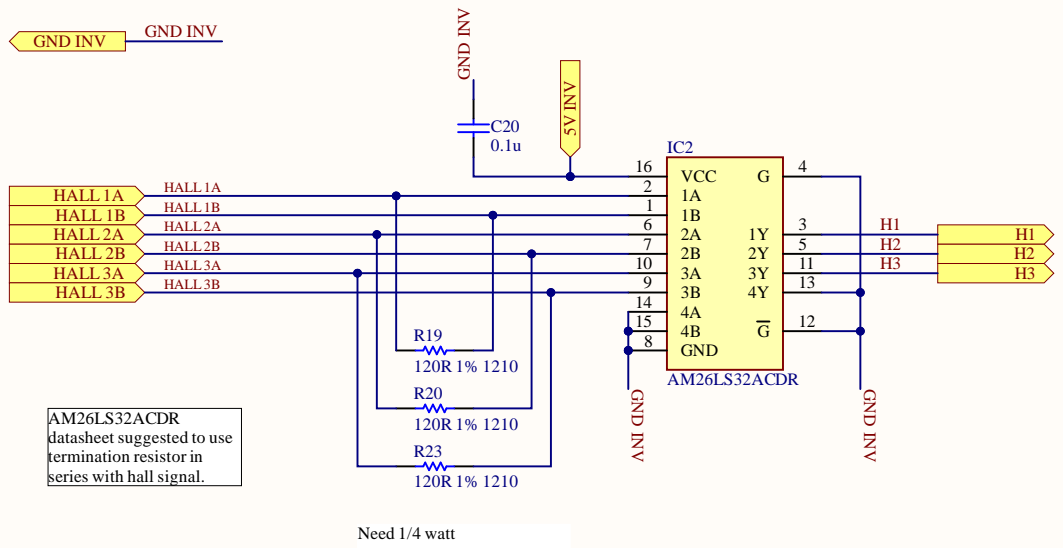
[picture p11: page 7]

Hall Diff to Analog

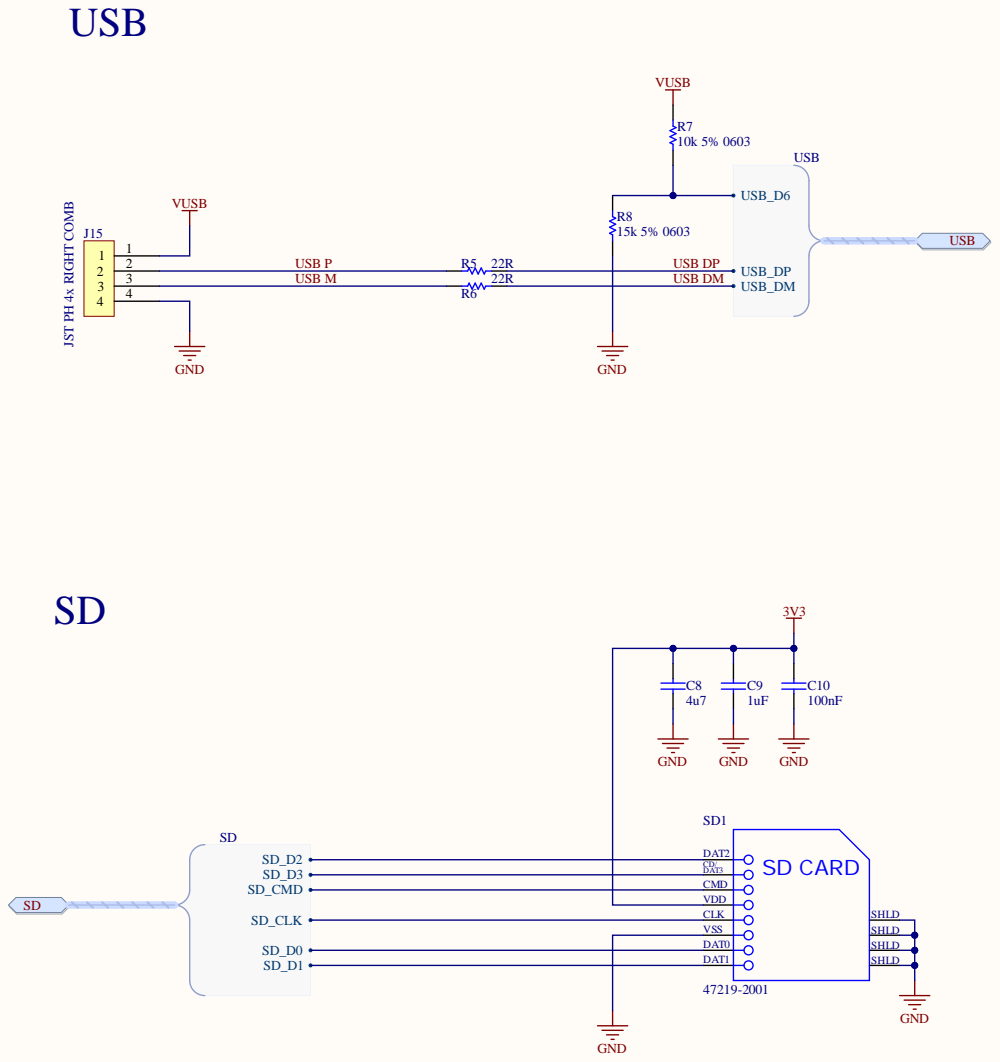
[picture p12: page 8]

JST PH 4x RIGHT COMB

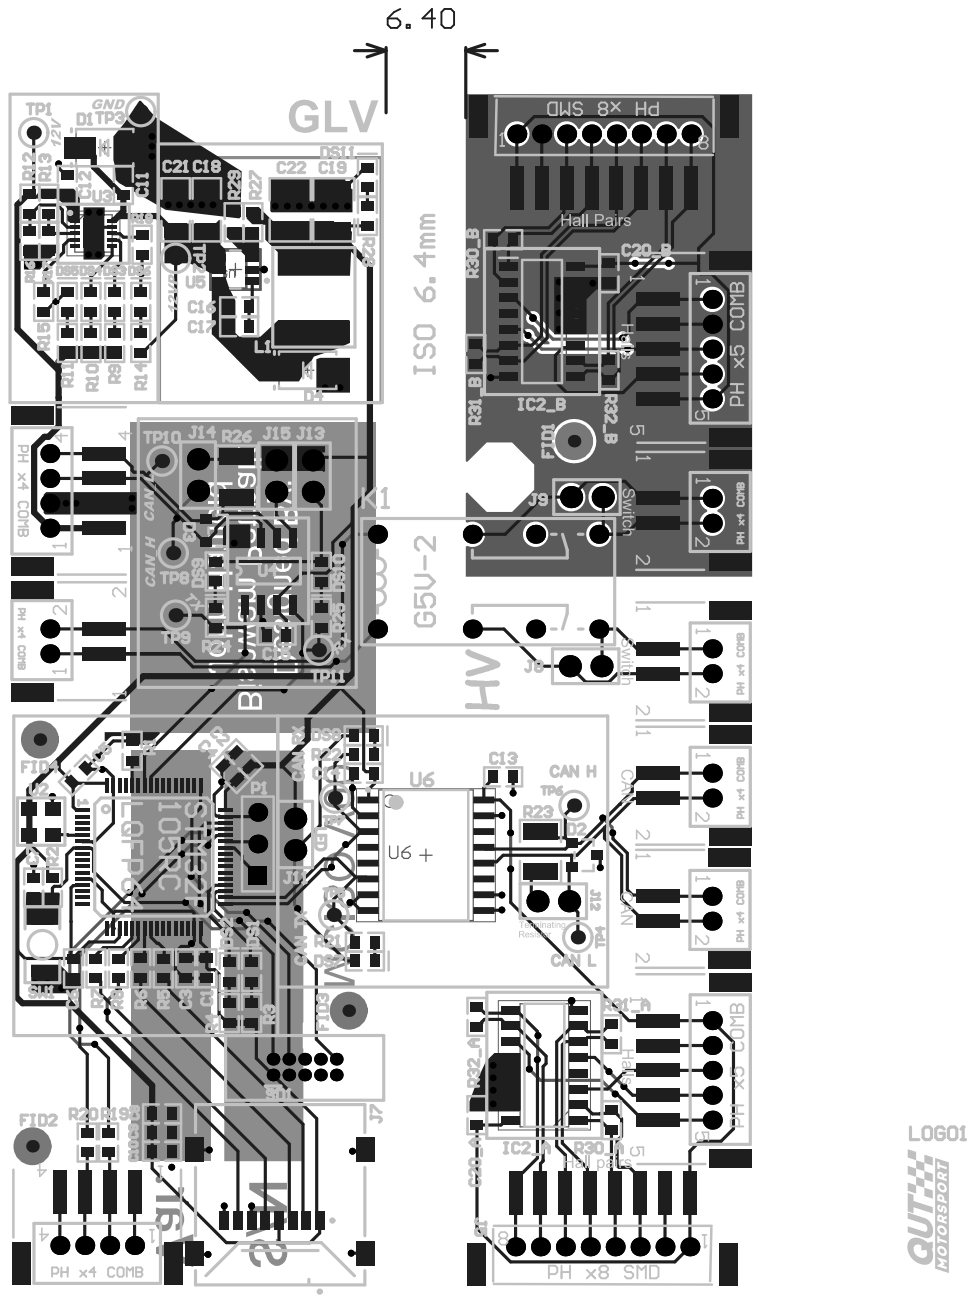
[picture p13: page 9]

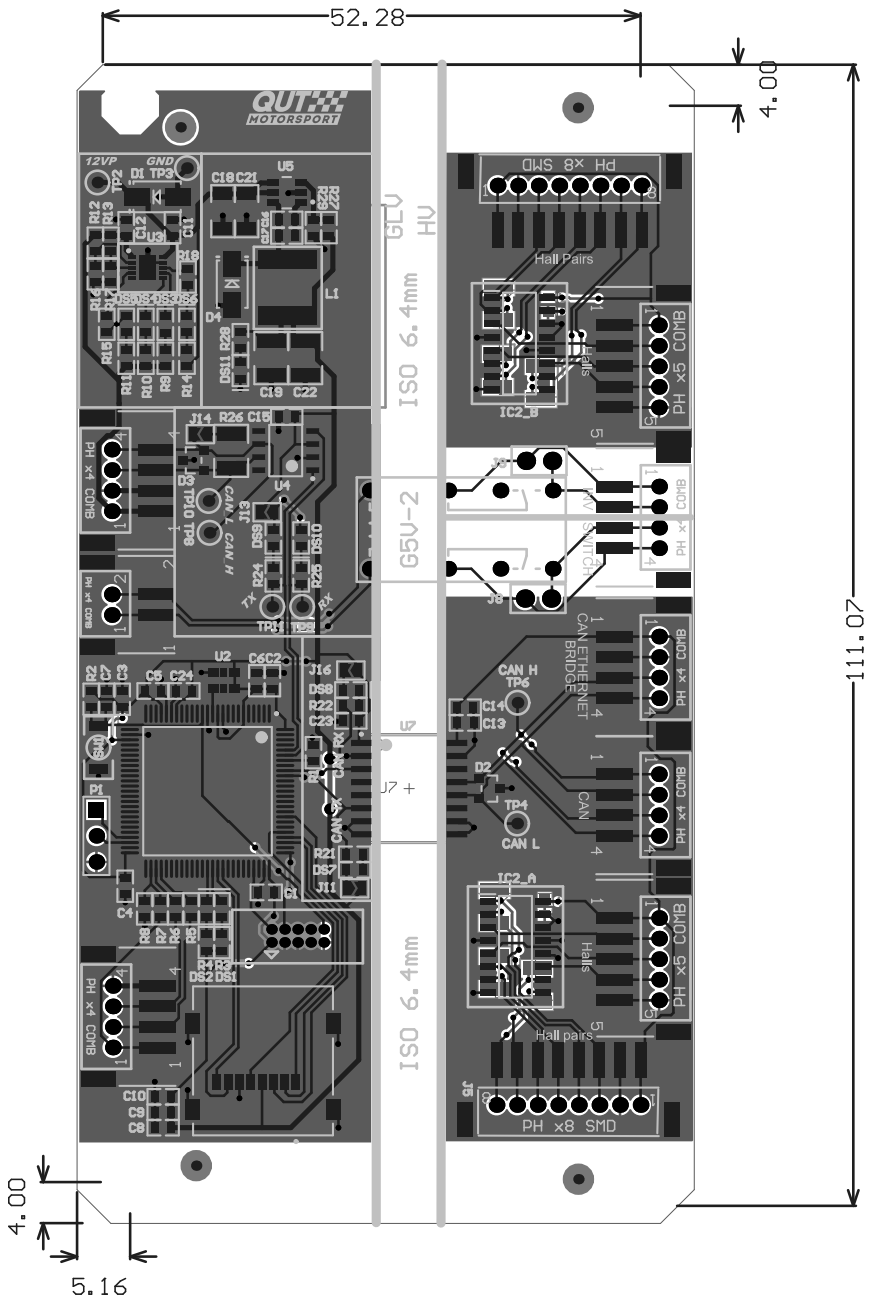
[picture p14: page 10]
