QUT-Motorsport/QUTMS_MCISO/hardware/Project Outputs for QUTMS_MCISO-V01/Draftsman Doc.pdf

A

B

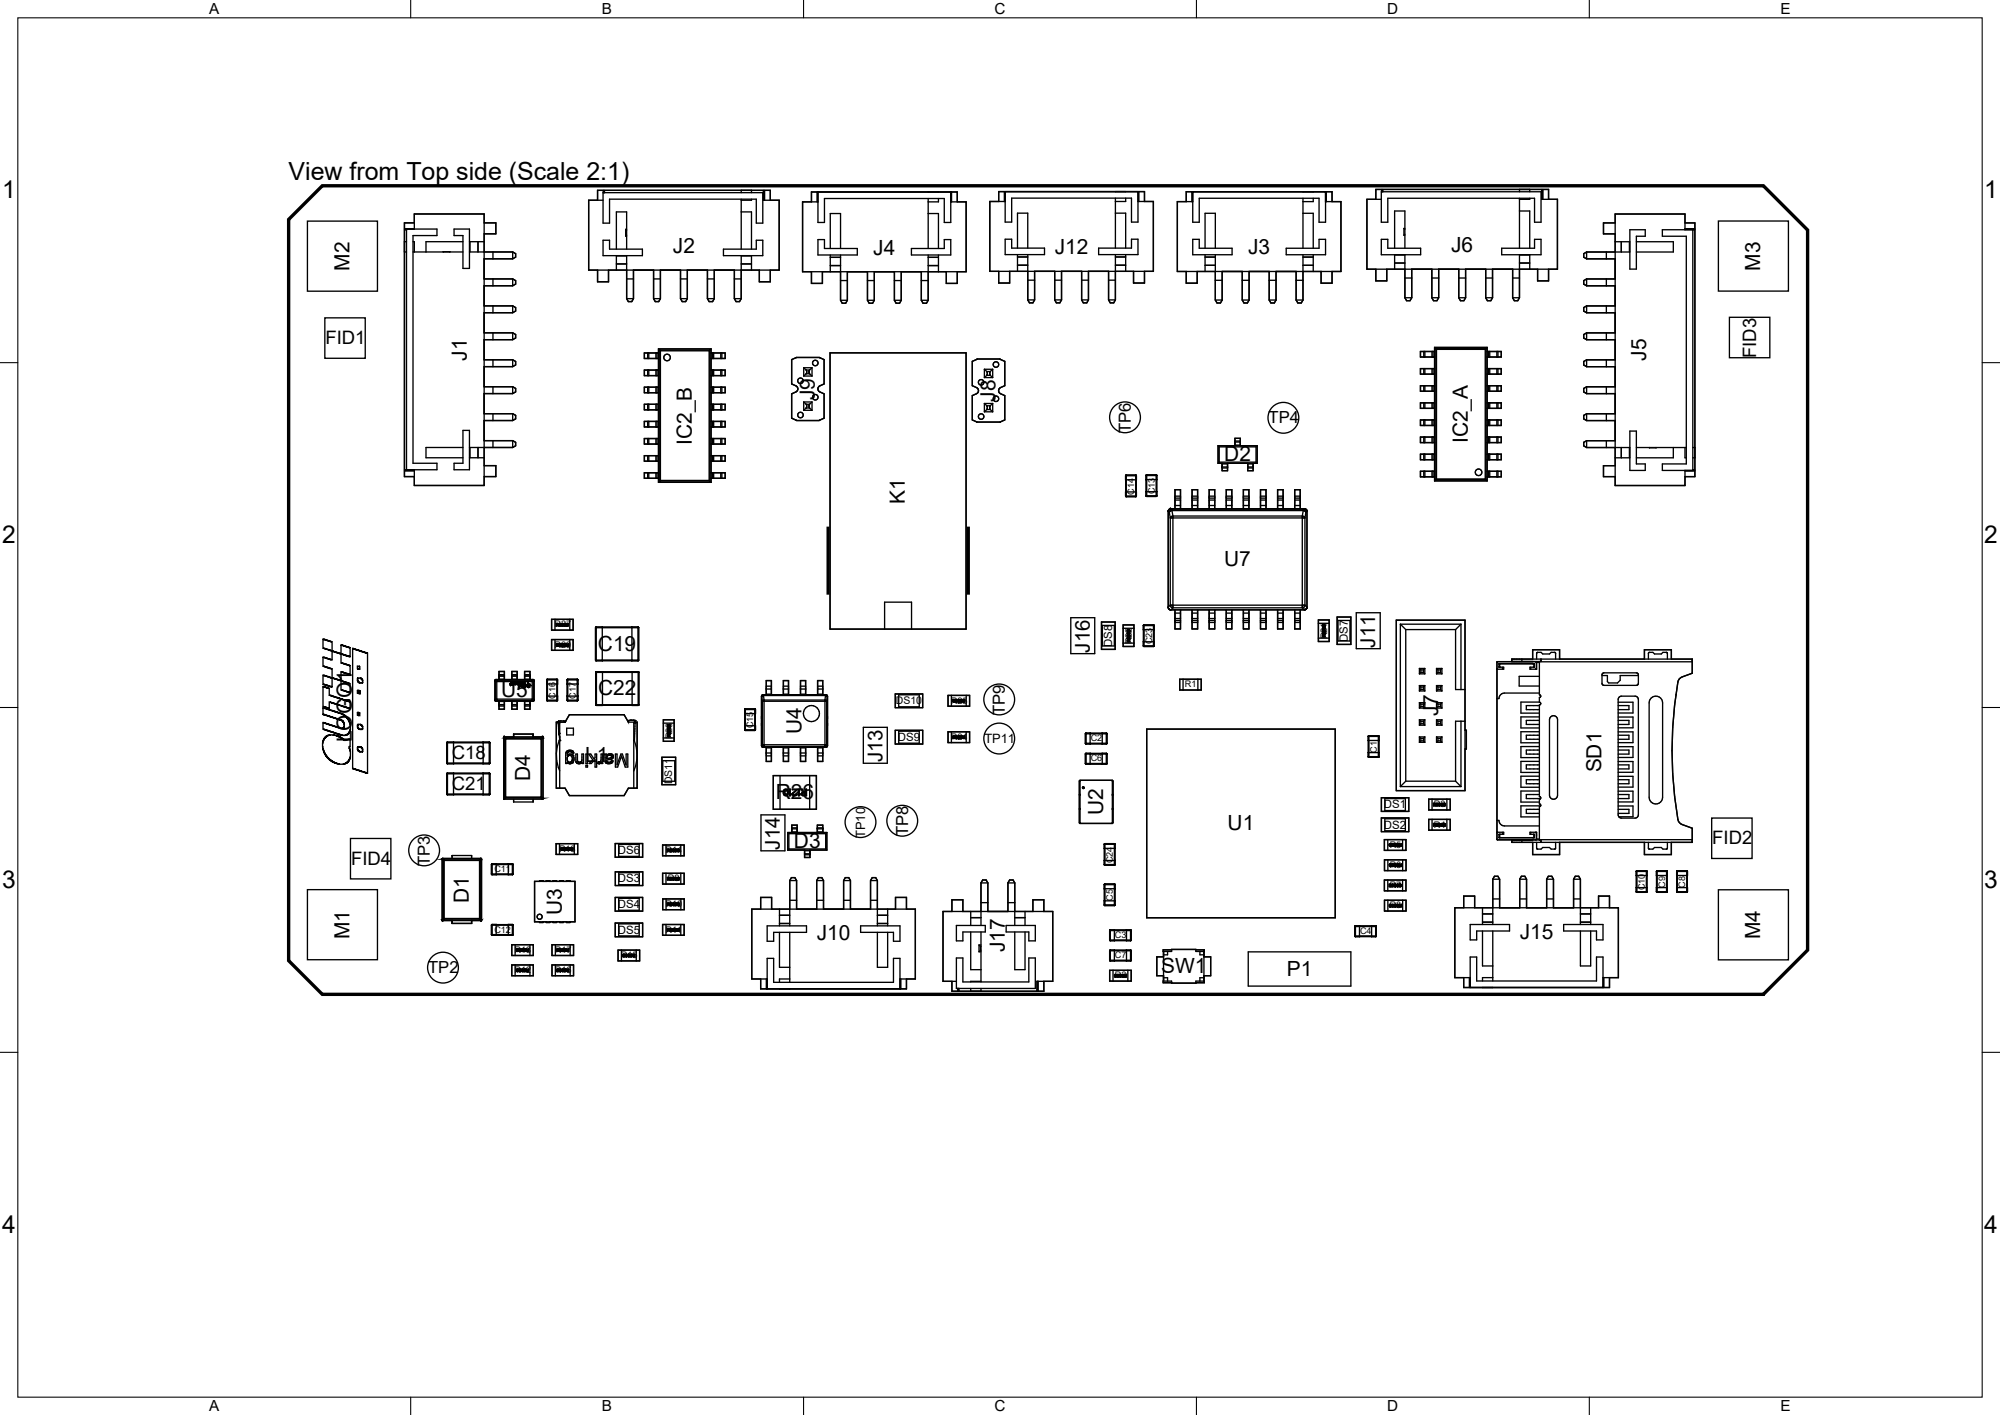
[picture p15: page 1]

View from Top side (Scale 2:1)
