QUT-Motorsport/QUTMS_MCISO/(list of files, drawings)

Other design files:
hardware/MCISO-S01-V00-Master.SchDoc
hardware/MCISO-S02-V00-12VProtection.SchDoc
hardware/MCISO-S03-V00-CAN_MAIN.SchDoc
hardware/MCISO-S04-V00-Microcontroller.SchDoc
hardware/MCISO-S05-V00-CANIsolation.SchDoc
hardware/MCISO-S06-V00-HALL_DIFFB.SchDoc
hardware/MCISO-S06-V00-PSU3V3.SchDoc
hardware/MCISO-S07-V00-Master-PSU3V3-300mA.SchDoc
hardware/QUTMS-MCISOLibrary.SchLib
hardware/QUTMS_MCISO-V01.PrjPcb
old version/CAN_MAIN.SchDoc
old version/Isolator_for_CAN.SchDoc
old version/MCISO-S01-V00-Master.SchDoc
old version/MCISO-S02-V00-PSU5VA.SchDoc
old version/MCISO-S02-V00-PSU5VB.SchDoc
old version/MCISO-S03-V00-PSU5VB.SchDoc
old version/MCISO-S04-V00-Microcontroller.SchDoc
old version/MCISO-S06-V00-PSU3V3.SchDoc
old version/MCISO-S08-V00-HallDifferentials.SchDoc
