QUT-Motorsport/QUTMS_MCISO/software/Core/Src/main.c

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
/* Includes ------------------------------------------------------------------*/
#include "main.h"
#include "can.h"
#include "iwdg.h"
#include "usart.h"
#include "gpio.h"

/* USER CODE BEGIN Includes */
#include <stdio.h>
#include <sys/unistd.h>
#include <string.h>
#include <stdlib.h>
#include <CAN_VESC.h>
#include <CAN_MCISO.h>
#include <Timer.h>
#include <CAN_BMU.h>
#include <CAN_VCU.h>
/* USER CODE END Includes */


/* USER CODE BEGIN PV */
// hcan1 == GLV
// hcan2 == HV
// 0 - left, eg FL (0) and RL (2)
// 1 - right, eg FR (1) and RR (3)
#define MCISO_ID 1

MCISO_HeartbeatState_t MCISO_heartbeatState;

#define INVERTER_COUNT 2
#define HEARTBEAT_TIMEOUT 300U

typedef struct heartbeat_state {
	bool BMU;
	bool VCU_CTRL;

	bool inverter[INVERTER_COUNT];

	uint32_t hb_inv_start[INVERTER_COUNT];

	uint32_t hb_BMU_start;
	uint32_t hb_VCU_CTRL_start;
} heartbeat_state_t;

/* USER CODE END PV */

void SystemClock_Config(void);
/* USER CODE BEGIN 0 */
ms_timer_t timer_heartbeat;
heartbeat_state_t hbStates;
BMU_HeartbeatState_t BMU_hbState;

// heartbeat
void setup_heartbeat();
void heartbeat_timer_cb(void *args);
bool check_bad_heartbeat();

// IWDG
void setup_WDG();

/* USER CODE END 0 */

/**
 * @brief  The application entry point.
 * @retval int
 */
int main(void) {
	/* MCU Configuration--------------------------------------------------------*/

	/* Reset of all peripherals, Initializes the Flash interface and the Systick. */
	HAL_Init();

	/* Configure the system clock */
	SystemClock_Config();

	/* Initialize all configured peripherals */
	MX_GPIO_Init();
	MX_CAN1_Init();
	MX_CAN2_Init();
	MX_USART3_UART_Init();
	//MX_IWDG_Init();
	/* USER CODE BEGIN 2 */

	CAN_setup();
	setup_heartbeat();
	setup_WDG();

	// Turning on failsafe lights
	HAL_GPIO_WritePin(LED1_GPIO_Port, LED1_Pin, SET);
	HAL_GPIO_WritePin(LED2_GPIO_Port, LED2_Pin, SET);
	/* USER CODE END 2 */

	/* Infinite loop */
	/* USER CODE BEGIN WHILE */

	CAN_MSG_Generic_t msg;
	CAN_TxHeaderTypeDef header;

	//bool first_inv_msg = false;

	while (1) {
		check_bad_heartbeat();

		timer_update(&timer_heartbeat, NULL);
		//timer_update(&timer_WDG, NULL);

		// inverter to car
		while (queue_next(&CAN2_Rx, &msg)) {
			if (msg.ID_TYPE == 1) {
				// extended ID, check if VESC
				uint8_t vesc_ID = (msg.ID & 0xFF);
				uint8_t vesc_type_ID = msg.ID >> 8;

				// check that this is actually a VESC message
				if (vesc_type_ID <= VESC_CAN_PACKET_BMS_SOC_SOH_TEMP_STAT) {
					if (vesc_ID == (MCISO_ID)) {
						hbStates.hb_inv_start[0] = HAL_GetTick();
						hbStates.inverter[0] = true;
						MCISO_heartbeatState.errorFlags.HB_INV0 = 0;
					} else if (vesc_ID == (MCISO_ID + 2)) {
						hbStates.hb_inv_start[1] = HAL_GetTick();
						hbStates.inverter[1] = true;
						MCISO_heartbeatState.errorFlags.HB_INV1 = 0;
					}
				}
			}

			// msg from inverter side, just forward
			header.ExtId = msg.ID;
			header.StdId = msg.ID;
			header.IDE = msg.ID_TYPE == 1 ? CAN_ID_EXT : CAN_ID_STD;
			header.RTR = CAN_RTR_DATA;
			header.DLC = msg.DLC;

			send_can_msg(&hcan1, &header, msg.data);
		}

		// car to inverter
		while (queue_next(&CAN1_Rx, &msg)) {
			if (msg.ID == BMU_Heartbeat_ID) {
				Parse_BMU_Heartbeat(msg.data, &BMU_hbState);

				hbStates.hb_BMU_start = HAL_GetTick();
				hbStates.BMU = true;
				MCISO_heartbeatState.errorFlags.HB_BMU = 0;

				if (BMU_hbState.stateID == BMU_STATE_TS_ACTIVE) {
					MCISO_heartbeatState.stateID = MCISO_STATE_FORWARD;
				} else {
					MCISO_heartbeatState.stateID = MCISO_STATE_START;
				}
			} else if (msg.ID == (VCU_Heartbeat_ID | VCU_ID_CTRL)) {
				// control VCU
				hbStates.hb_VCU_CTRL_start = HAL_GetTick();
				hbStates.VCU_CTRL = true;
				MCISO_heartbeatState.errorFlags.HB_VCU_CTRL = 0;
			} else {
				// if bmu in TS active
				if ((BMU_hbState.stateID == BMU_STATE_TS_ACTIVE)
						&& (hbStates.BMU)) {
					// if message for these inverters, forward on
					uint8_t vesc_ID = (msg.ID & 0xFF);
					uint8_t vesc_type_ID = msg.ID >> 8;

					// check that this is actually a VESC message
					if (vesc_type_ID <= VESC_CAN_PACKET_BMS_SOC_SOH_TEMP_STAT) {
						if ((vesc_ID == (MCISO_ID))
								|| (vesc_ID == (MCISO_ID + 2))) {
							// this good so forward
							header.ExtId = msg.ID;
							header.StdId = msg.ID;
							header.IDE =
									msg.ID_TYPE == 1 ? CAN_ID_EXT : CAN_ID_STD;
							header.RTR = CAN_RTR_DATA;
							header.DLC = msg.DLC;

							send_can_msg(&hcan2, &header, msg.data);
						}
					}
				}
			}

		}

		//HAL_IWDG_Refresh(&hiwdg);

		/* USER CODE END WHILE */

		/* USER CODE BEGIN 3 */
	}
	/* USER CODE END 3 */
}

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
/* USER CODE BEGIN 4 */
#ifdef PRINTF_TO_UART
/** Override _write to log to UART */
int _write(int file, char *data, int len) {
	if ((file != STDOUT_FILENO) && (file != STDERR_FILENO)) {
		return -1;
	}
	HAL_StatusTypeDef s = HAL_UART_Transmit(&huart3, (uint8_t*) data, len,
	HAL_MAX_DELAY);

	return (s == HAL_OK ? len : 0);
}
#endif

bool check_bad_heartbeat() {
	bool success = true;

	if ((HAL_GetTick() - hbStates.hb_inv_start[0]) > HEARTBEAT_TIMEOUT) {
		success = false;
		hbStates.inverter[0] = false;
		MCISO_heartbeatState.errorFlags.HB_INV0 = 1;
	}

	if ((HAL_GetTick() - hbStates.hb_inv_start[1]) > HEARTBEAT_TIMEOUT) {
		success = false;
		hbStates.inverter[1] = false;
		MCISO_heartbeatState.errorFlags.HB_INV1 = 1;
	}

	if ((HAL_GetTick() - hbStates.hb_BMU_start) > HEARTBEAT_TIMEOUT) {
		success = false;
		hbStates.BMU = false;
		MCISO_heartbeatState.errorFlags.HB_BMU = 1;
		MCISO_heartbeatState.stateID = MCISO_STATE_START;
	}

	if ((HAL_GetTick() - hbStates.hb_VCU_CTRL_start) > HEARTBEAT_TIMEOUT) {
		success = false;
		hbStates.VCU_CTRL = false;
		MCISO_heartbeatState.errorFlags.HB_VCU_CTRL = 1;
	}

	return success;
}

void setup_heartbeat() {
	MCISO_heartbeatState.stateID = MCISO_STATE_START;
	MCISO_heartbeatState.errorFlags.rawMem = 0;
	timer_heartbeat = timer_init(50, true, heartbeat_timer_cb);

	hbStates.hb_inv_start[0] = 0;
	hbStates.hb_inv_start[1] = 0;
	hbStates.hb_BMU_start = 0;
	hbStates.hb_VCU_CTRL_start = 0;

	timer_start(&timer_heartbeat);
}

bool WDG_reset = false;

void setup_WDG() {
	MX_IWDG_Init();

	//timer_WDG = timer_init(50, true, WDG_timer_cb);
	//timer_start(&timer_WDG);

	// check if started from watchdog reset

	// check iwdg
	if (__HAL_RCC_GET_FLAG(RCC_FLAG_IWDGRST)) {
		WDG_reset = true;
		HAL_GPIO_WritePin(LED1_GPIO_Port, LED1_Pin, RESET);
		HAL_GPIO_WritePin(LED2_GPIO_Port, LED2_Pin, RESET);
		MCISO_heartbeatState.errorFlags.WATCHDOG = 1;
	}
}

void heartbeat_timer_cb(void *args) {
	HAL_IWDG_Refresh(&hiwdg);
	MCISO_Heartbeat_t msg = Compose_MCISO_Heartbeat(MCISO_ID,
			&MCISO_heartbeatState);
	CAN_TxHeaderTypeDef header = { .ExtId = msg.id, .IDE =
	CAN_ID_EXT, .RTR = CAN_RTR_DATA, .DLC = sizeof(msg.data),
			.TransmitGlobalTime = DISABLE };

	send_can_msg(&hcan1, &header, msg.data);
}

/* USER CODE END 4 */
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
