QUT-Motorsport/QUTMS_MCISO/software/Core/Inc/main.h

#define LED2_Pin GPIO_PIN_6
#define LED2_GPIO_Port GPIOC
#define LED1_Pin GPIO_PIN_7
#define LED1_GPIO_Port GPIOC
#define CAN2_HV_RX_Pin GPIO_PIN_5
#define CAN2_HV_RX_GPIO_Port GPIOB
#define CAN2_HV_TX_Pin GPIO_PIN_6
#define CAN2_HV_TX_GPIO_Port GPIOB
#define CAN1_GLV_RX_Pin GPIO_PIN_8
#define CAN1_GLV_RX_GPIO_Port GPIOB
#define CAN1_GLV_TX_Pin GPIO_PIN_9
#define CAN1_GLV_TX_GPIO_Port GPIOB
