QUT-Motorsport/QUTMS_MCISO/software/Core/Inc/can.h

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
/* Define to prevent recursive inclusion -------------------------------------*/
#ifndef __CAN_H__
#define __CAN_H__

#ifdef __cplusplus
extern "C" {
#endif

/* Includes ------------------------------------------------------------------*/
#include "main.h"

/* USER CODE BEGIN Includes */
#include <queue.h>
/* USER CODE END Includes */

extern CAN_HandleTypeDef hcan1;

extern CAN_HandleTypeDef hcan2;

/* USER CODE BEGIN Private defines */
extern uint32_t txMailbox_CAN1;
extern uint32_t txMailbox_CAN2;

extern message_queue_t CAN1_Rx;
extern message_queue_t CAN2_Rx;
extern message_queue_t CAN1_Tx;
extern message_queue_t CAN2_Tx;

/* USER CODE END Private defines */

void MX_CAN1_Init(void);
void MX_CAN2_Init(void);

/* USER CODE BEGIN Prototypes */
void CAN_setup( void );
HAL_StatusTypeDef send_can_msg(CAN_HandleTypeDef *hcan, CAN_TxHeaderTypeDef *pHeader, uint8_t aData[]);
void can_tx_interrupt(CAN_HandleTypeDef *hcan);
void can_rx_interrupt(CAN_HandleTypeDef *hcan, int fifo);
/* USER CODE END Prototypes */

#ifdef __cplusplus
}
#endif

#endif /* __CAN_H__ */
