QUT-Motorsport/QUTMS_MCISO/(commit log)

2021-02-03 Initial project setup
    [QUTMS_MCISO-V00.PrjPcb]
2021-02-03 remove extra folder
    [QUTMS_MCISO-V00.PrjPcb]
2021-02-09 MCISO Schematic Drafts
    Schematic drafts for MCISO board. PCB placement not commenced. Currently all required features have been included. Project-specific schematic and PCB libraries have been generated.
    [A.SchDoc, AMU-S04-V00-Microcontroller.SchDoc, BMS-S06-V01-IsolatedCAN.SchDoc, Buck_converter12_3.3V.SchDoc, Buck_converter12_5v.SchDoc, Component_from_magic.SchDoc, JST - PH - SMD (R) - 2Pin - 2.00mm.stp, JST - PH - SMD (R) - 5Pin - 2.00mm.stp]
2021-02-09 MCISO schematic
    little changes made to schematic
    [MCISO-S01-V00-Master.SchDoc, QUTMS_MCISO-V01.PrjPcb]
2021-02-11 actually save project to github
    [A.SchDoc, AMU-S04-V00-Microcontroller.SchDoc, BMS-S06-V01-IsolatedCAN.SchDoc, Buck_converter12_3.3V.SchDoc, Buck_converter12_5v.SchDoc, Component_from_magic.SchDoc, Isolator_for_CAN.SchDoc, JST - PH - SMD (R) - 2Pin - 2.00mm.stp]
2021-02-12 Schematic reviewed, awaiting 3v3, 5v converter. Preparing my pcb design.
    Kind regards,
    [CAN_MAIN.SchDoc, MCISO-S01-V00-Master.SchDoc, MCISO-S04-V00-Microcontroller.SchDoc, MCISO-S05-V00-CANIsolation.SchDoc, MCISO-S08-V00-HallDifferentials.SchDoc, QUTMS-MCISOLibrary.PcbLib, QUTMS-MCISOLibrary.SchLib, QUTMS_MCISO-V01.PrjPcb]
2021-02-12 complete schematic for CAN iso...
    [CAN_MAIN.SchDoc, MCISO-S01-V00-Master.SchDoc, MCISO-S04-V00-Microcontroller.SchDoc, MCISO-S08-V00-HallDifferentials.SchDoc, QUTMS-MCISOLibrary.PcbLib, QUTMS-MCISOLibrary.SchLib, QUTMS_MCISO-V01.PrjPcb]
2021-02-23 MCISO PCB done
    [CAN_MAIN.SchDoc, Isolator_for_CAN.SchDoc, MCISO-S01-V00-Master.SchDoc, MCISO-S02-V00-PSU5VA.SchDoc, MCISO-S02-V00-PSU5VB.SchDoc, MCISO-S03-V00-CAN_MAIN.SchDoc, MCISO-S03-V00-PSU5VB.SchDoc, MCISO-S04-V00-Microcontroller.SchDoc]
2021-02-24 Final version for PCB
    Included image, final version for PCB
    [QUTMS-MCISOLibrary.PcbLib, QUTMS_MCISO-V01.PrjPcb]
2021-02-24 PCB little changes
    [QUTMS_MCISO-V01.PrjPcb]
2021-03-05 Mark review
    [MCISO-S01-V00-Master.SchDoc, MCISO-S03-V00-CAN_MAIN.SchDoc, MCISO-S06-V00-HALL_DIFFB.SchDoc, QUTMS-MCISOLibrary.PcbLib, QUTMS-MCISOLibrary.SchLib]
2021-03-10 MARK REVIEW for PLACEMENT OF COMPONENT
    [MCISO-S01-V00-Master.SchDoc, QUTMS-MCISOLibrary.SchLib]
2021-03-30 Good files
    [Component_from_magic.SchDoc, Isolator_for_CAN.SchDoc, MCISO-S02-V00-12VProtection.SchDoc, MCISO-S02-V00-PSU5VA.SchDoc, MCISO-S02-V00-PSU5VB.SchDoc, MCISO-S03-V00-PSU5VB.SchDoc, MCISO-S04-V00-Microcontroller.SchDoc, MCISO-S05-V00-CANIsolation.SchDoc]
2021-03-30 Schematics and placement initial
    Swap MX120G to JST, add 2 headers for inverter switch relay. Component placement update
    [MCISO-S01-V00-Master.SchDoc, MCISO-S02-V00-12VProtection.SchDoc]
2021-03-30 Changes to 3V3 schematic and playing around with 3V3 routing
    [MCISO-S05-V00-CANIsolation.SchDoc, MCISO-S07-V00-Master-PSU3V3-300mA.SchDoc]
2021-03-30 started on thy routing
    [MCISO-S01-V00-Master.SchDoc]
2021-03-31 Layout changes. Changed CAN pins to optimise routing
    [MCISO-S02-V00-12VProtection.SchDoc, MCISO-S04-V00-Microcontroller.SchDoc]
2021-04-01 Hall routing
    [MCISO-S01-V00-Master.SchDoc]
2021-04-02 playing with placement and routing
    [MCISO-S01-V00-Master.SchDoc, MCISO-S05-V00-CANIsolation.SchDoc]
2021-04-02 Move 3V3 led to make room for trace
2021-04-02 Started power routing
2021-04-02 PCB routing in progress
    [MCISO-S01-V00-Master.SchDoc, QUTMS_MCISO-V01.PrjPcb]
2021-04-02 GLV and INV A routing done
    [MCISO-S02-V00-12VProtection.SchDoc, MCISO-S07-V00-Master-PSU3V3-300mA.SchDoc, QUTMS-MCISOLibrary.PcbLib]
2021-04-03 Board size update
2021-04-03 Cut out where relay pins are not 6.4mm apart.
    Spacing needs to be 3.2mm through air or 6.4mm over surface. Pins on relay are 6.1mm apart so need a cut out
2021-04-06 CAN ISO changed to 16 pin soic which has availability
    [MCISO-S01-V00-Master.SchDoc, MCISO-S05-V00-CANIsolation.SchDoc]
2021-04-08 Start on implementing the new micro which is available
    [MCISO-S04-V00-Microcontroller.SchDoc]
2021-04-09 Placement done
    [MCISO-S03-V00-CAN_MAIN.SchDoc]
2021-04-13 New oscillator
    [MCISO-S04-V00-Microcontroller.SchDoc, QUTMS_MCISO-V01.xls]
2021-04-15 Pre mark review
    [MCISO-S02-V00-12VProtection.SchDoc, MCISO-S03-V00-CAN_MAIN.SchDoc, MCISO-S04-V00-Microcontroller.SchDoc, MCISO-S05-V00-CANIsolation.SchDoc, MCISO-S06-V00-HALL_DIFFB.SchDoc, MCISO-S07-V00-Master-PSU3V3-300mA.SchDoc]
2021-04-17 Remove HV can term resistor. Add CAN ethernet bridge header in. Combine relay output into four way
    [MCISO-S01-V00-Master.SchDoc, MCISO-S05-V00-CANIsolation.SchDoc, QUTMS-MCISOLibrary.SchLib]
2021-04-17 Update isolation barriers to silkscreen and dont remove solder mask
2021-04-17 Add libraries to project. Update can isolator schematic symbol. Change CAN led jumpers.
    [MCISO-S05-V00-CANIsolation.SchDoc, QUTMS-MCISOLibrary.SchLib, QUTMS_MCISO-V01.PrjPcb]
2021-04-17 Updates from prev commit
    [MCISO-S05-V00-CANIsolation.SchDoc]
2021-04-17 Updates to net labels and change micro on MCU sheet
    [MCISO-S03-V00-CAN_MAIN.SchDoc, MCISO-S04-V00-Microcontroller.SchDoc, MCISO-S05-V00-CANIsolation.SchDoc]
2021-04-17 Micro brought locally. Schematic for it updated. NRST and JTAG added
    [MCISO-S04-V00-Microcontroller.SchDoc]
2021-04-17 Oscillator added
    [MCISO-S04-V00-Microcontroller.SchDoc]
2021-04-17 layout of 3v3 switcher fixed
    [MCISO-S06-V00-HALL_DIFFB.SchDoc]
2021-04-17 halls rerouted
    [MCISO-S01-V00-Master.SchDoc, MCISO-S03-V00-CAN_MAIN.SchDoc, MCISO-S04-V00-Microcontroller.SchDoc]
2021-04-17 Routing almost done
    [MCISO-S01-V00-Master.SchDoc, MCISO-S02-V00-12VProtection.SchDoc, MCISO-S04-V00-Microcontroller.SchDoc, MCISO-S05-V00-CANIsolation.SchDoc]
2021-04-18 Board shape plus few extra fixes
2021-04-20 mark review and new routing
    [MCISO-P01-V06-NewMicro.GBL, MCISO-P01-V06-NewMicro.GBO, MCISO-P01-V06-NewMicro.GBS, MCISO-P01-V06-NewMicro.GKO, MCISO-P01-V06-NewMicro.GM1, MCISO-P01-V06-NewMicro.GTL, MCISO-P01-V06-NewMicro.GTO, MCISO-P01-V06-NewMicro.GTS]
2021-04-21 hall difs and 3v3 layout and routing
    [MCISO-S01-V00-Master.SchDoc]
2021-04-27 move trace. done
2021-04-27 Fabrication files
    [MCISO-P01-V06-NewMicro.GBL, MCISO-P01-V06-NewMicro.GBO, MCISO-P01-V06-NewMicro.GBS, MCISO-P01-V06-NewMicro.GKO, MCISO-P01-V06-NewMicro.GM1, MCISO-P01-V06-NewMicro.GTL, MCISO-P01-V06-NewMicro.GTO, MCISO-P01-V06-NewMicro.GTS]
2021-05-09 Step file exported
    [QUTMS_MCISO-V01.PrjPcb]
2021-05-12 Assembly files
    [MCISO-S03-V00-CAN_MAIN.SchDoc, MCISO-S04-V00-Microcontroller.SchDoc, MCISO-S06-V00-HALL_DIFFB.SchDoc, MCISO-S07-V00-Master-PSU3V3-300mA.SchDoc, Pick Place for MCISO-P01-V06-NewMicro.csv, Pick Place for MCISO-P01-V06-NewMicro.xlsx, Pick Place for MCISO-P01-V06-NewMicroCorrectorigin.xlsx, QUTMS_MCISO-V01 Assemble.xlsx]
2021-05-27 Change JST footprints
    [MCISO-S01-V00-Master.SchDoc]
2022-01-10 use correct can queue to check for heartbeats
    [main.c]
2022-03-10 edit filtering
2022-03-16 fix mciso to wait for vesc to turn on before it forwards messages
    [QUTMS_MCISO.ioc, can.c, can.h, main.c, main.h]
2023-03-27 update both canbus to 1mbps
